perc-sw/phyduino_pico2/docs/reviews/schematic_review_2026-10-06.html

# Phyduino Pico 2: Schematic Design Review

Functional and connectivity review of the four schematic sheets. Part-attribute errors are left for a separate review.

Branch: dev_reva_no_usbpd Rev: A Date: 2026-10-06 Status: critical and high findings #1–#8 resolved (#6–#8 on 2026-10-07); medium #10–#15, #24 and #26 closed; low #16–#22 and #25 closed, #23 deferred; follow-ups noted Basis: kicad-cli 10.0.4 netlist + ERC; datasheets in docs/pdf/datasheets, TPS25947, XC6190, ESP-AT docs

All Critical High Medium Low Toggle dark mode

## Findings by schematic sheet

Number of findings on each sheet, split by severity. Hover a segment for the finding numbers.

Show as table

## Checked and OK

- AP63200 feedback dividers: 3.33 V (196k/62k) and 4.99 V (157k/30k)
- TPS25947 eFuses: limit ≈ 3 A each (RILM 1.1 kΩ); windows ≈ 4.5–22.4 V (barrel/shield) and 4.5–5.6 V (USB); true reverse-current blocking makes the OR'd outputs valid
- TPS2121 pin mapping, highest-voltage mode, OV dividers (≈ 5.53 V), ILIM ≈ 2.6 A
- RP2350 core regulator: 3.3 µH inductor, 4.7 µF on VREG_VIN and DVDD, RC filter on VREG_AVDD
- Decoupling on IOVDD, DVDD and ADC_AVDD (ferrite + 100 nF)
- USB: 27 Ω series resistors, 5.1 kΩ CC resistors, ESD array, shield RC
- SWD connector pinout matches the Raspberry Pi 3-pin debug connector
- Arduino mapping: SPI1 on D10–D13, UART0 on D0/D1, I²C1 on D14/D15
- HSTX lanes on GPIO12–19 with ground between pairs on J7
- ADS7038 on SPI0; I²C0 pull-ups 5.1 kΩ; EEPROM 0x50 and expander 0x43 (no address conflict)
- Boot-select slide switch acting on flash CS through R49
- Shared QSPI bus between flash and PSRAM (apart from finding #4)

Sources: ESP-AT ESP32-C6 hardware connection (https://docs.espressif.com/projects/esp-at/en/latest/esp32c6/Get_Started/Hardware_connection.html) · Torex XC6190 datasheet (https://content.codico.com/fileadmin/media/download/datasheets/torex/xc6190-datasheet.pdf) · TI TPS25947 datasheet (https://www.ti.com/lit/ds/symlink/tps25947.pdf) · RP2350, TPS2121, ESP32-C6-MINI-1 and AP63200 datasheets in the repository.
