perc-sw/phyduino_pico2/docs/images/phyduino_pico2.png

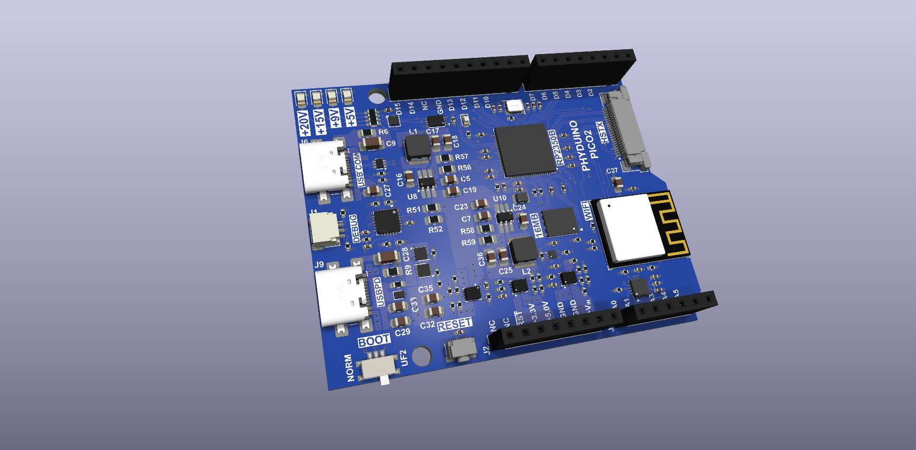
docs/images/phyduino_pico2.png
