perc-sw/phyduino_pico2/docs/pdf/board/phyduino_pico2-schematic.pdf

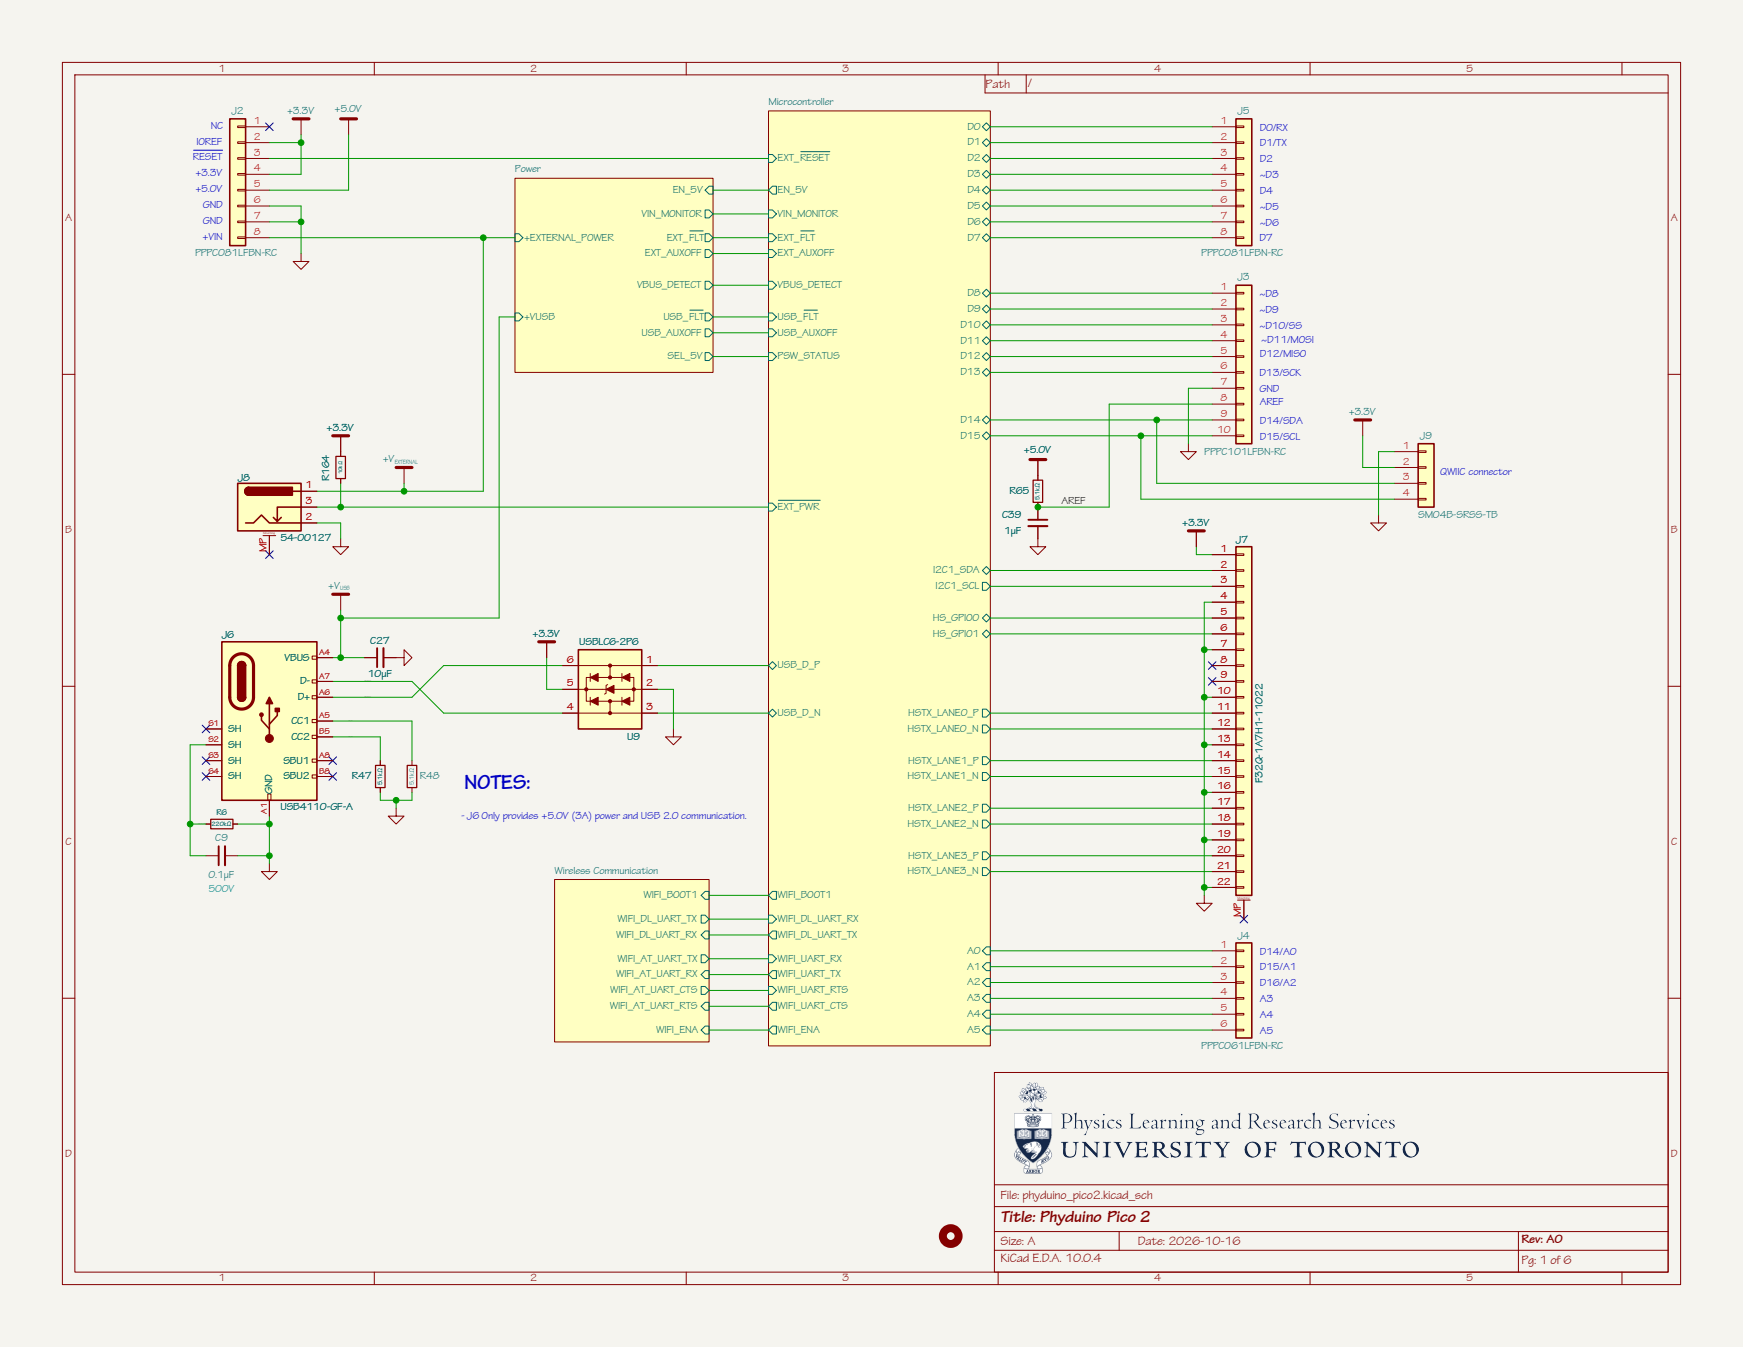
[picture p5: page 1]

10 10 11 11 | Mounting 123456789

12 12
13 13 14 14

15 15
16 16 17 17

- J6 Only provides +5.0V (3A) power and USB 2.0 communication.

File: phyduino_pico2.kicad_sch
Pg: 1 of 6 Title: Phyduino Pico 2

Size: A | Rev: A0
KiCad E.D.A. 10.0.4

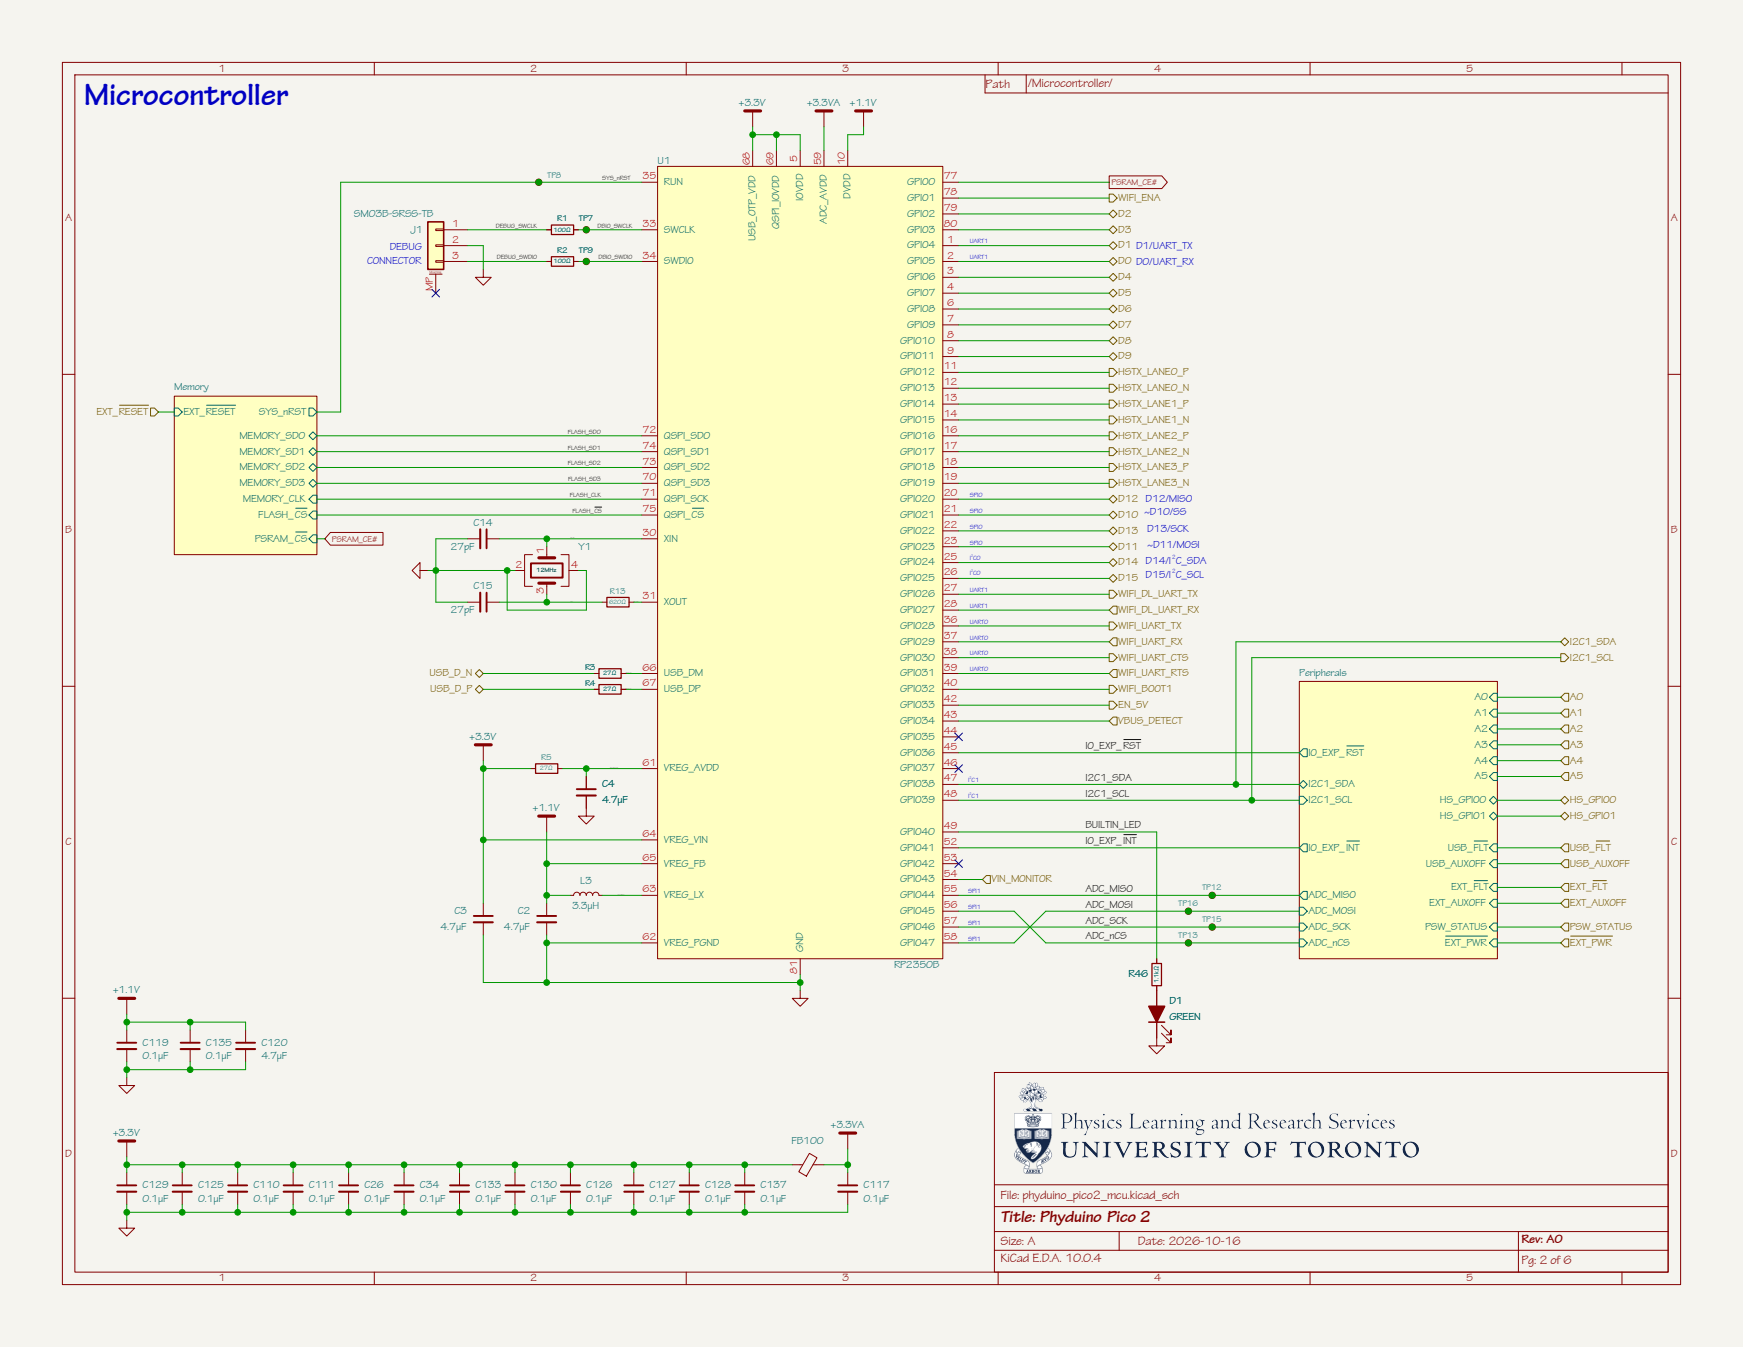
[picture p6: page 2]

I2C1_SDA I2C1
I2C1 I2C1_SCL

IO_EXP_ INT ADC_nCS VIN_MONITOR

SPI1 | TP16 TP15

File: phyduino_pico2_mcu.kicad_sch
Pg: 2 of 6 Title: Phyduino Pico 2

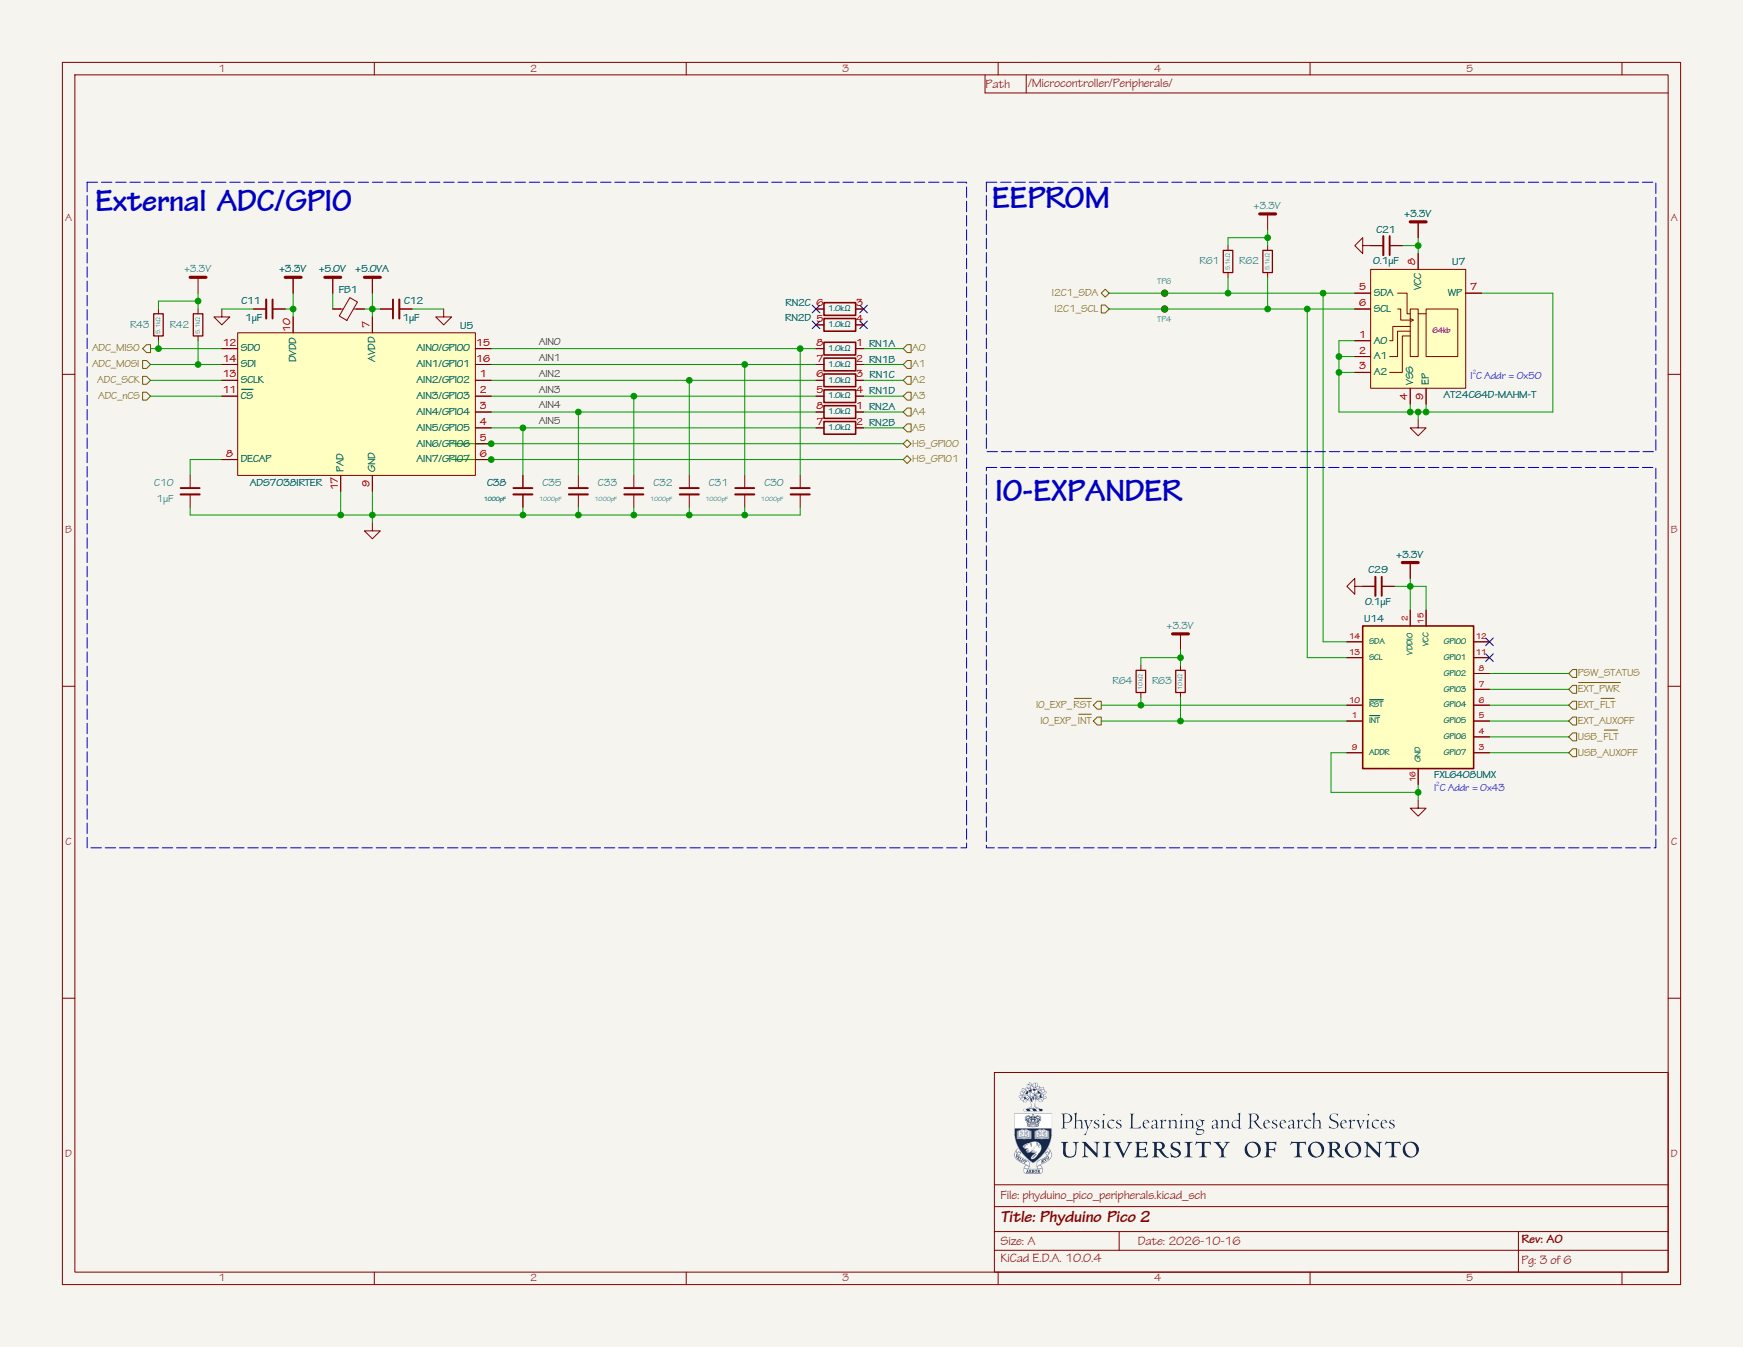
[picture p7: page 3]

File: phyduino_pico_peripherals.kicad_sch
Pg: 3 of 6 Title: Phyduino Pico 2

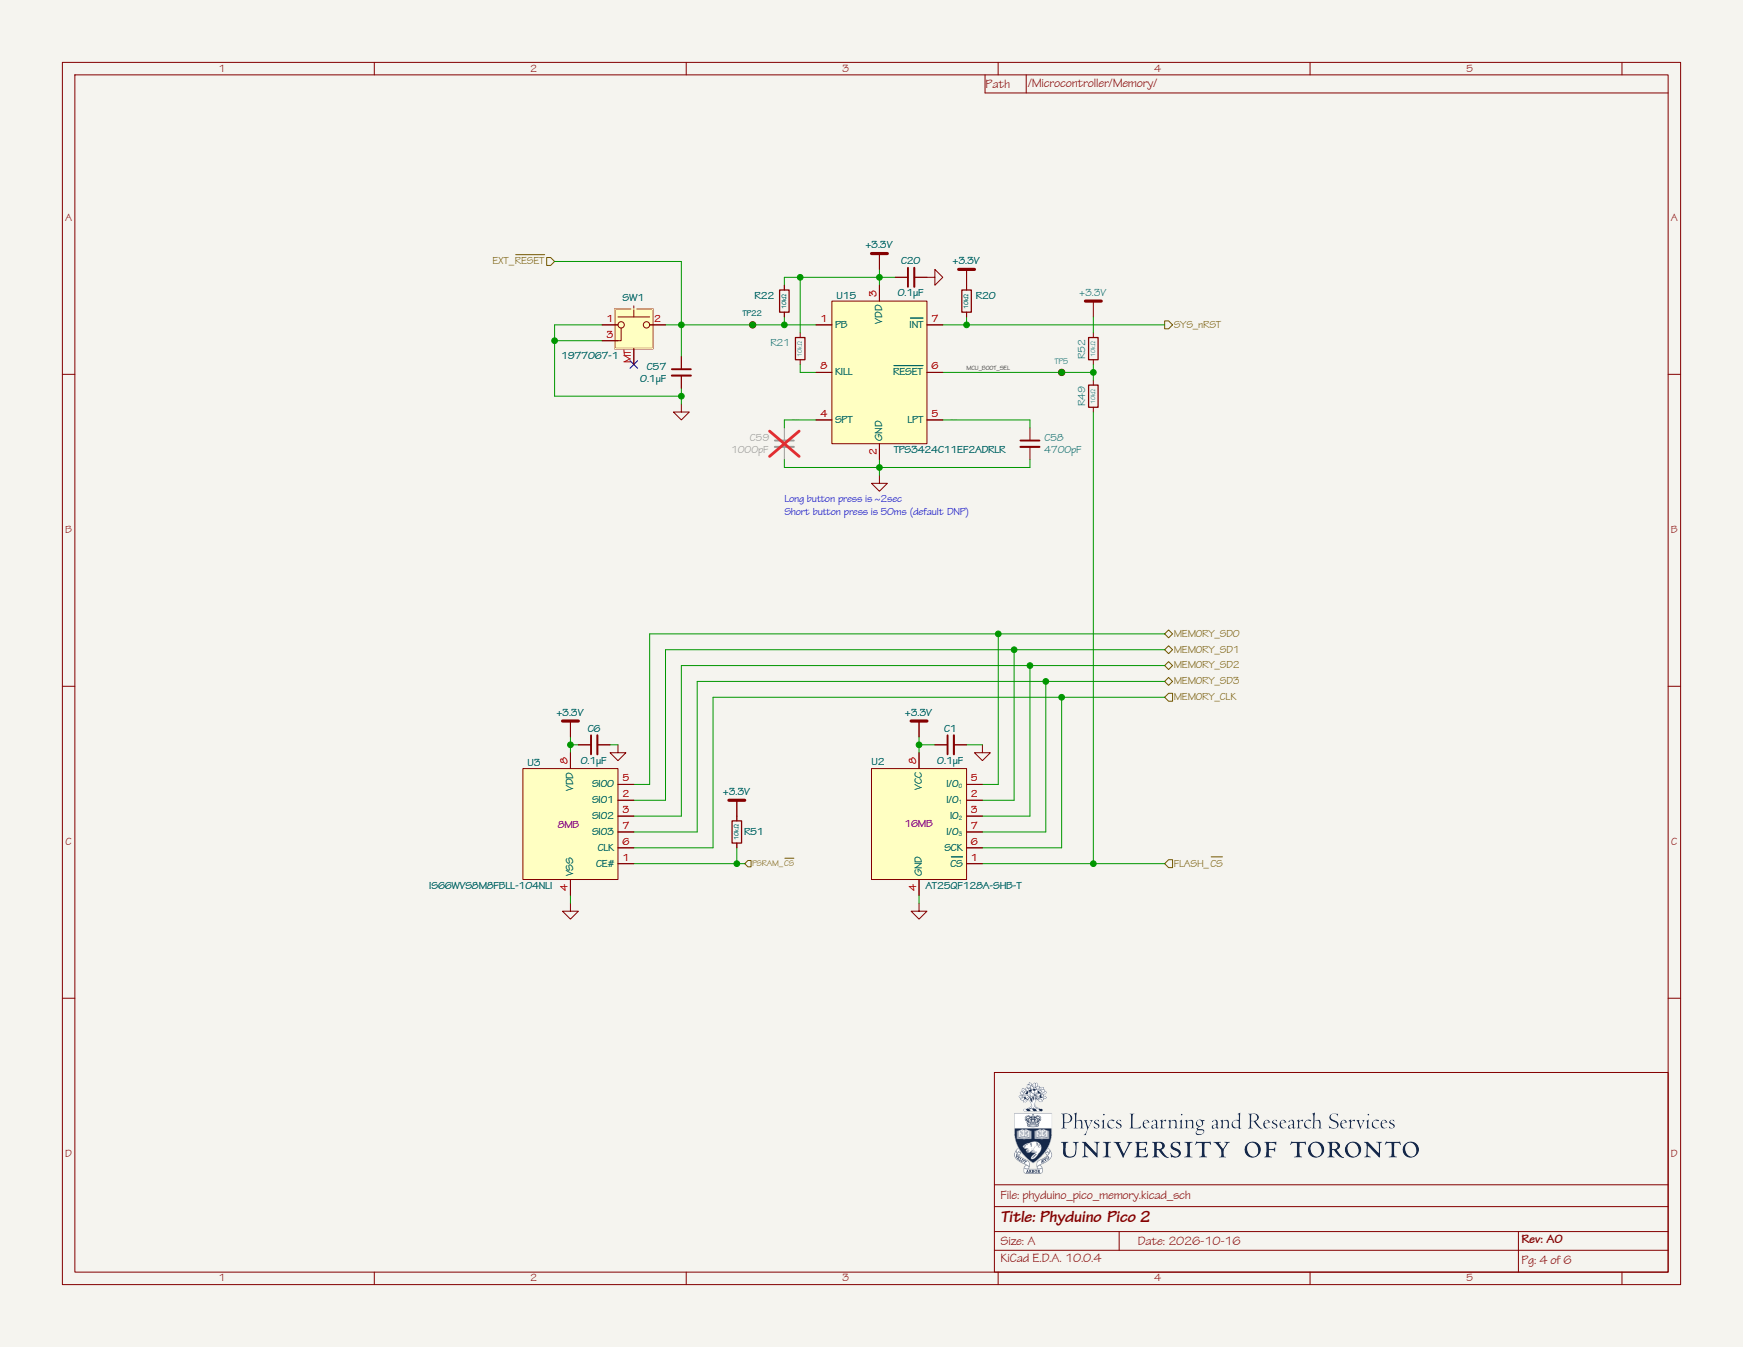
[picture p8: page 4]

File: phyduino_pico_memory.kicad_sch
Pg: 4 of 6 Title: Phyduino Pico 2

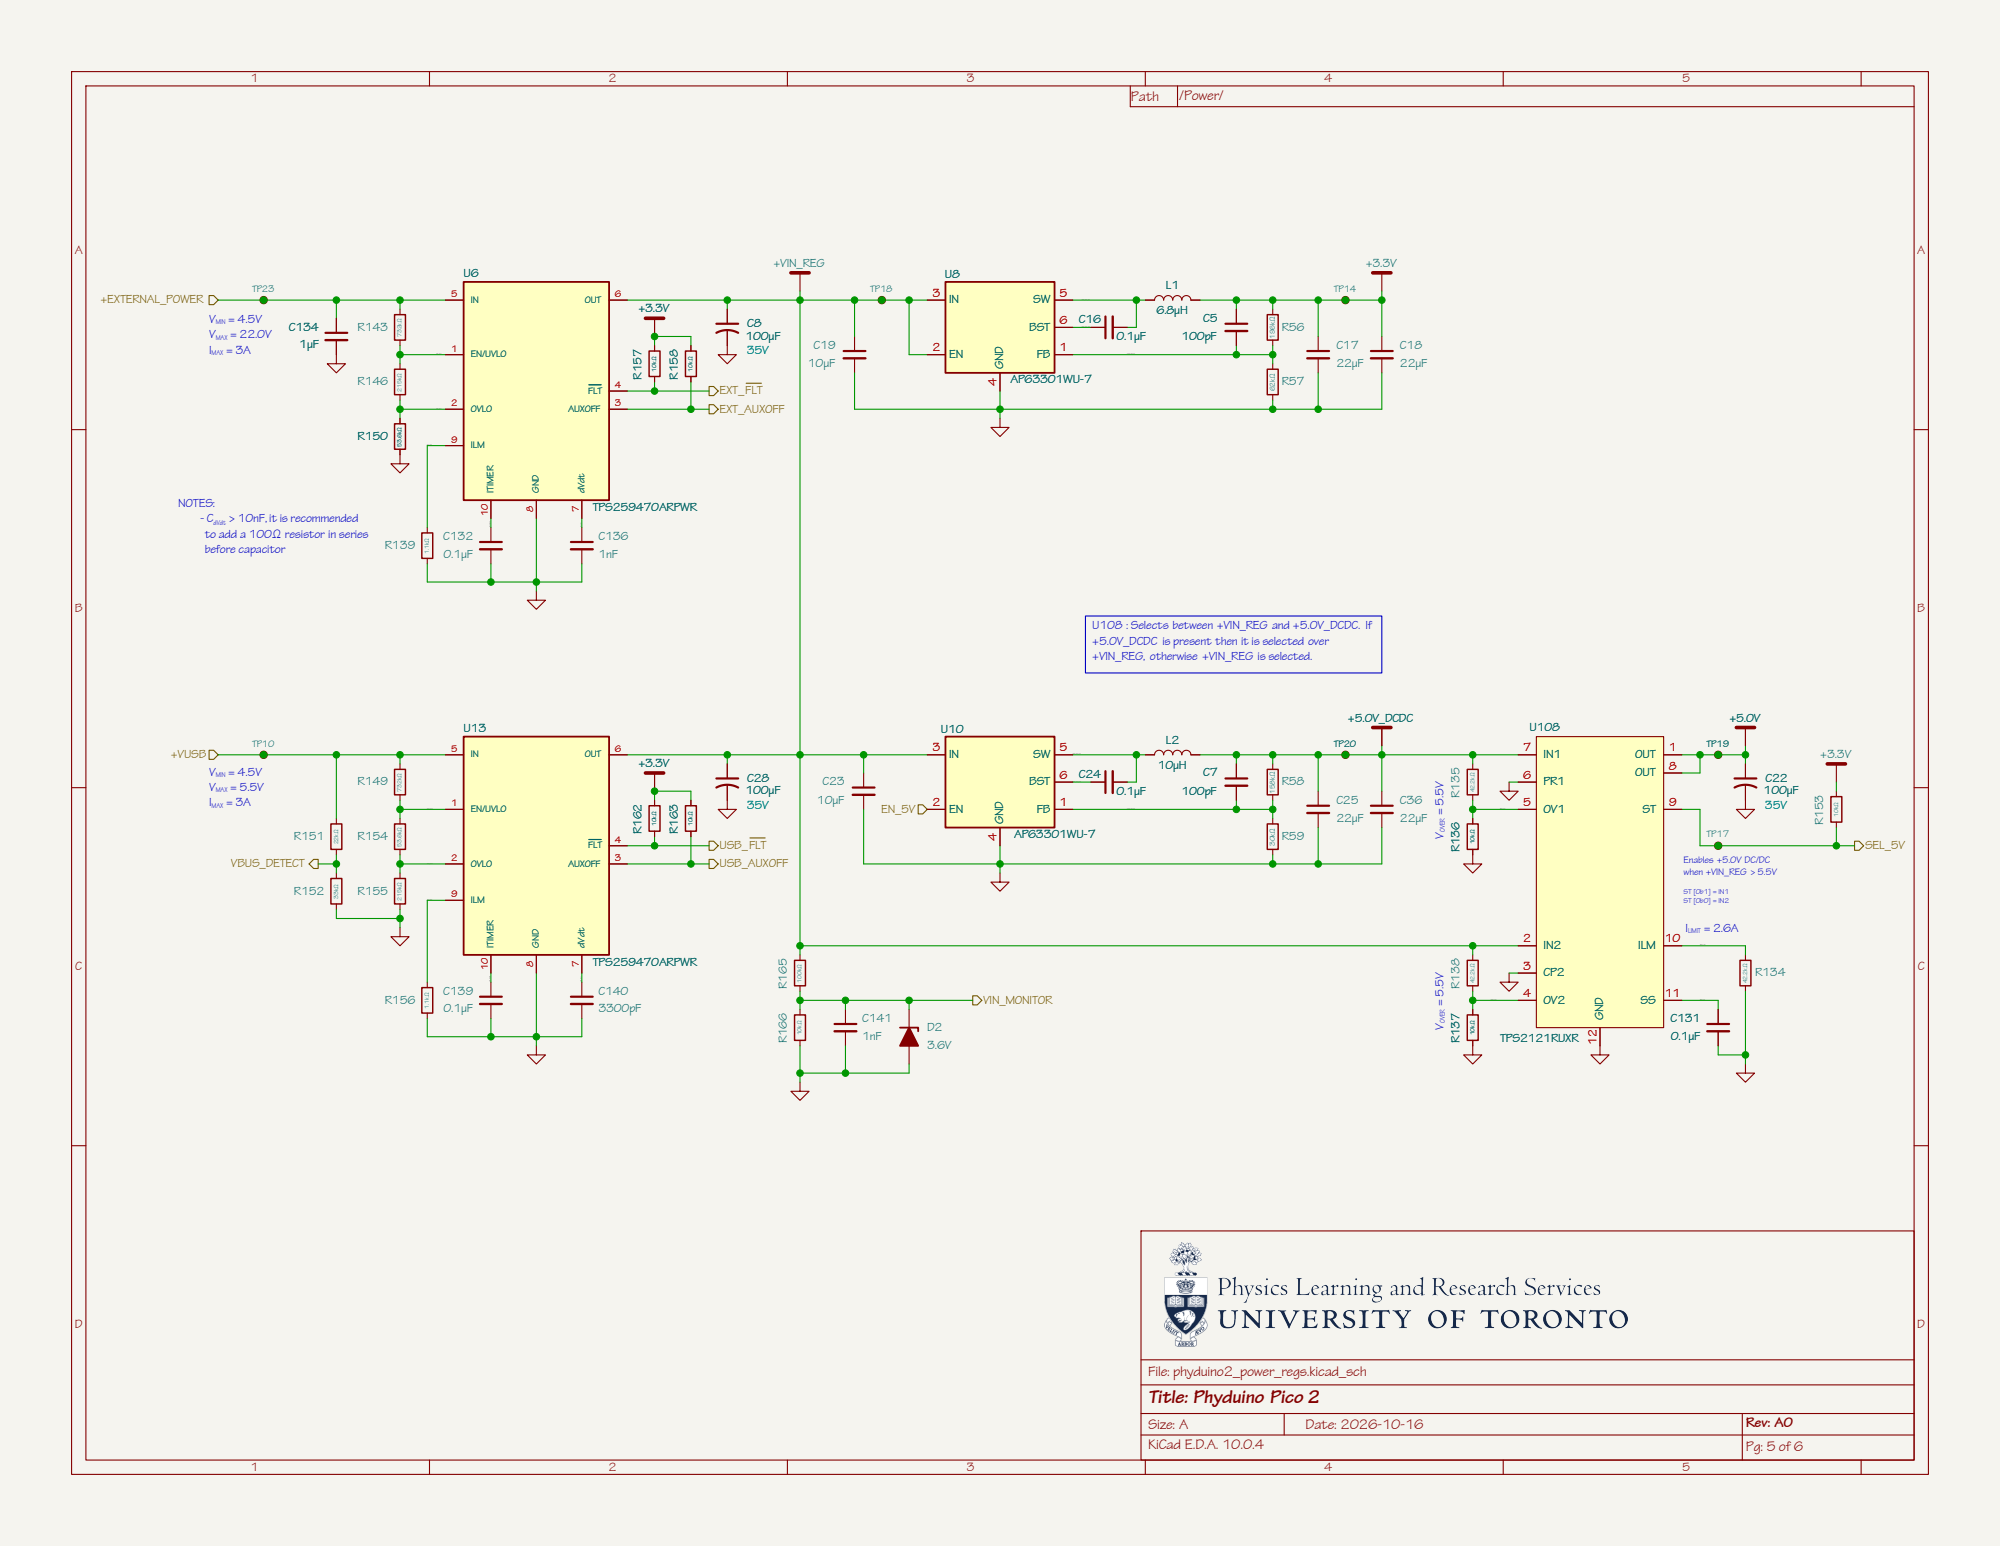
[picture p9: page 5]

Enables +5.0V DC/DC when +VIN_REG > 5.5V

File: phyduino2_power_regs.kicad_sch
Pg: 5 of 6 Title: Phyduino Pico 2

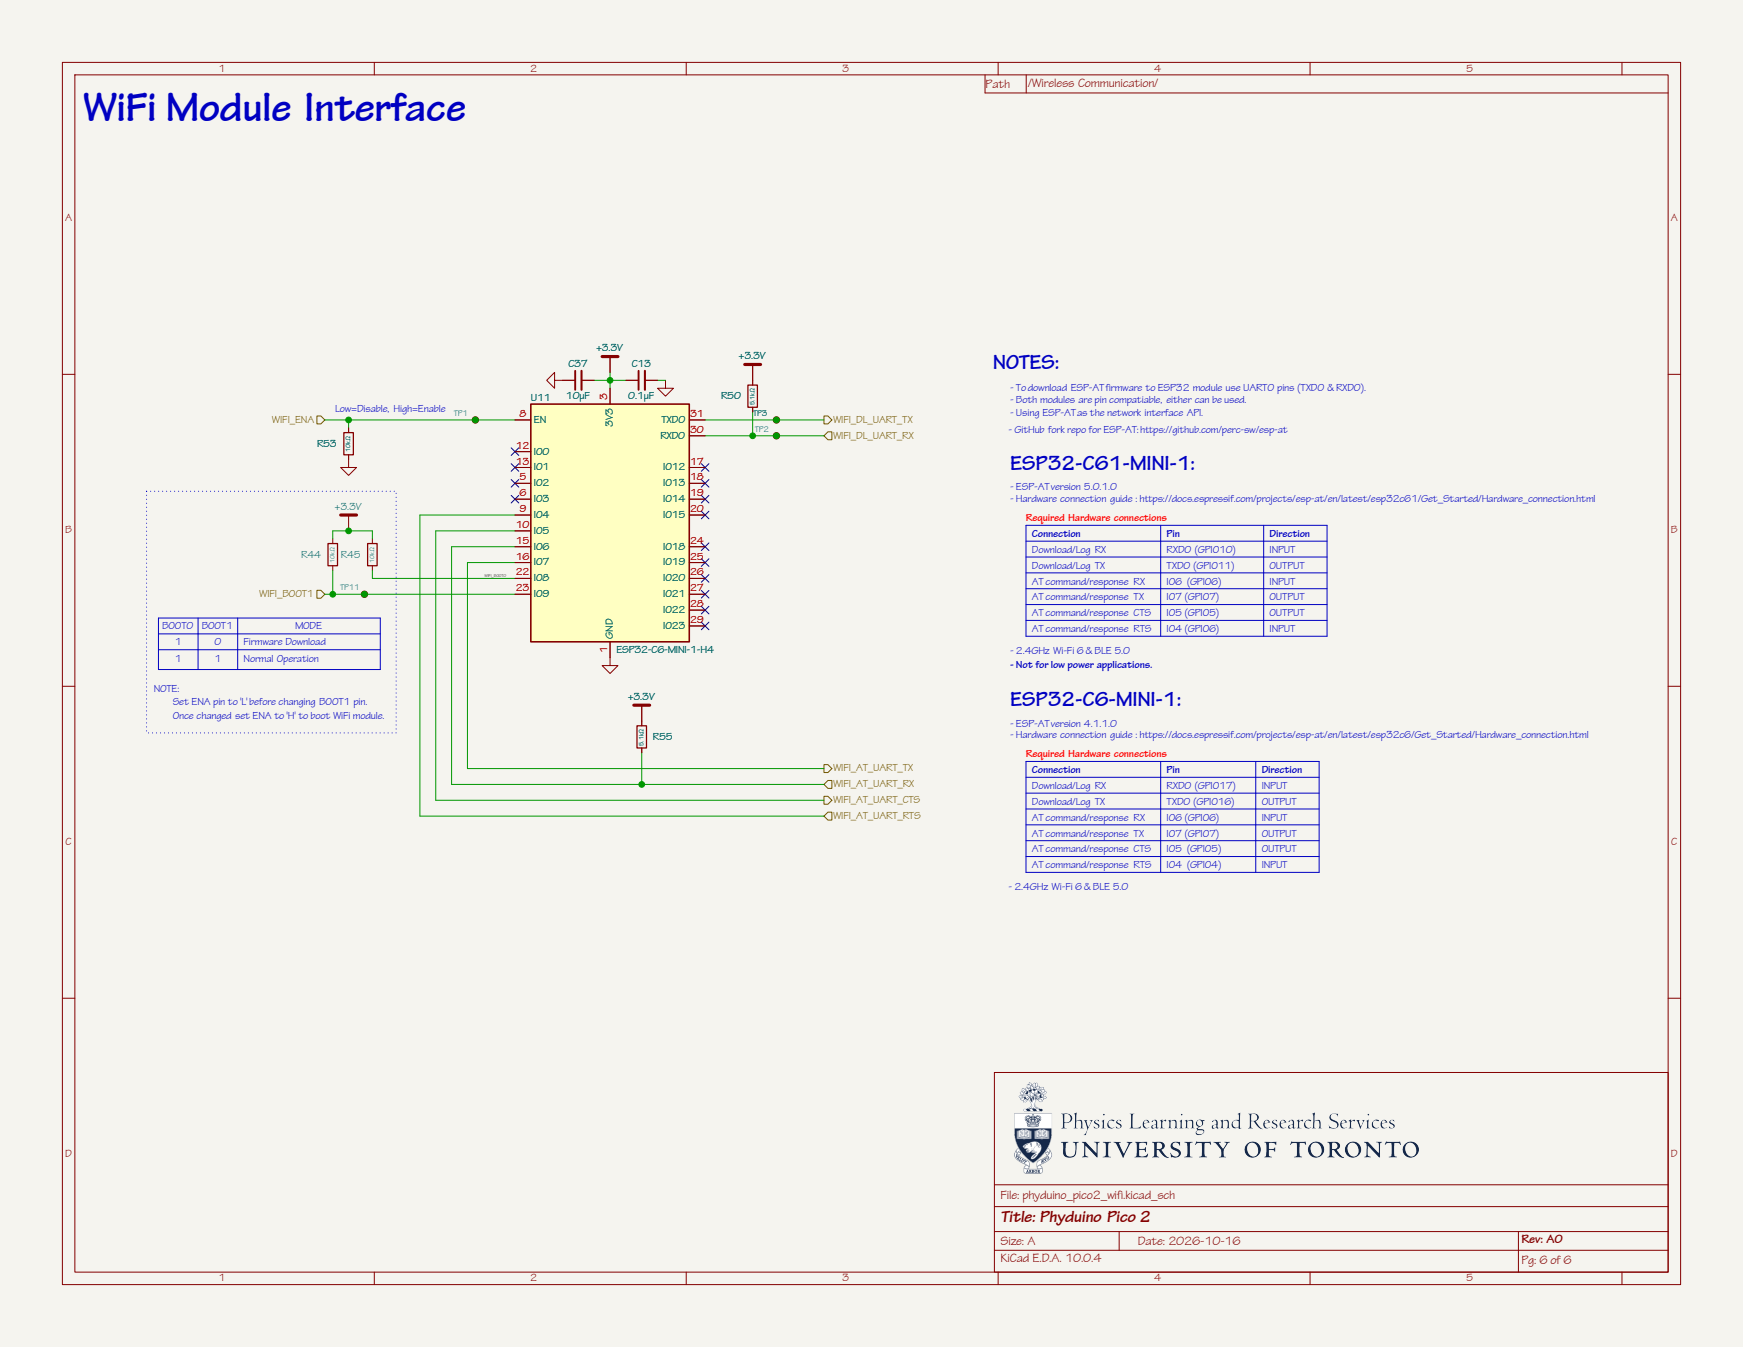
[picture p10: page 6]

Low=Disable, High=Enable WiFi Module Interface

- ESP-AT version 5.0.1.0 NOTES:

- To download ESP-AT firmware to ESP32 module use UART0 pins (TXD0 & RXD0). - Using ESP-AT as the network interface API. - GitHub fork repo for ESP-AT: https://github.com/perc-sw/esp-at
- Both modules are pin compatiable, either can be used. - 2.4GHz Wi-Fi 6 & BLE 5.0 - Not for low power applications.

- ESP-AT version 4.1.1.0 ESP32-C61-MINI-1:

- Hardware connection guide : https://docs.espressif.com/projects/esp-at/en/latest/esp32c61/Get_Started/Hardware_connection.html NOTE: Set ENA pin to 'L' before changing BOOT1 pin. Once changed set ENA to 'H' to boot WiFi module.

- Hardware connection guide : https://docs.espressif.com/projects/esp-at/en/latest/esp32c6/Get_Started/Hardware_connection.html
Required Hardware connections (https://docs.espressif.com/projects/esp-at/en/latest/esp32c5/Get_Started/Hardware_connection.html)

File: phyduino_pico2_wifi.kicad_sch
Pg: 6 of 6 Title: Phyduino Pico 2
