perc-sw/phyduino_pico2/docs/pdf/board/phyduino_pico2_pcb-inner2.pdf

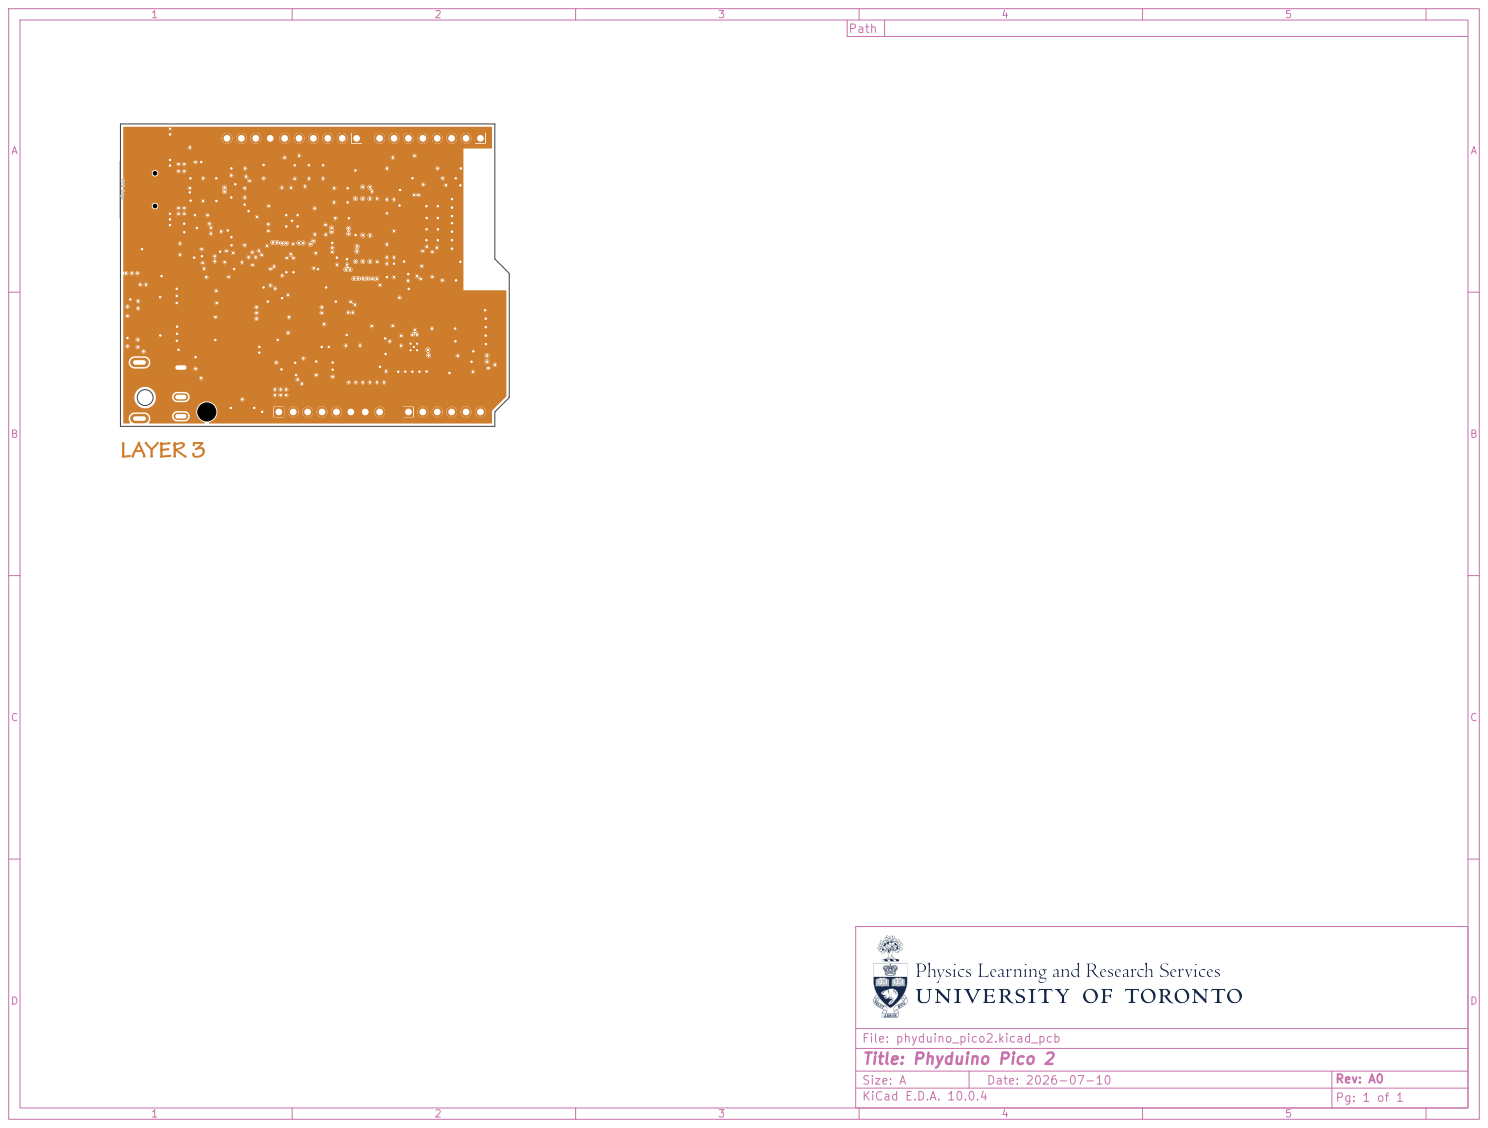
[picture p13: page 1]

Size: A | Rev: A0
KiCad E.D.A. 10.0.4 | Pg: 1 of 1
