perc-sw/phyduino_pico2/pdf/phyduino_pico2_pcb-bottom.pdf

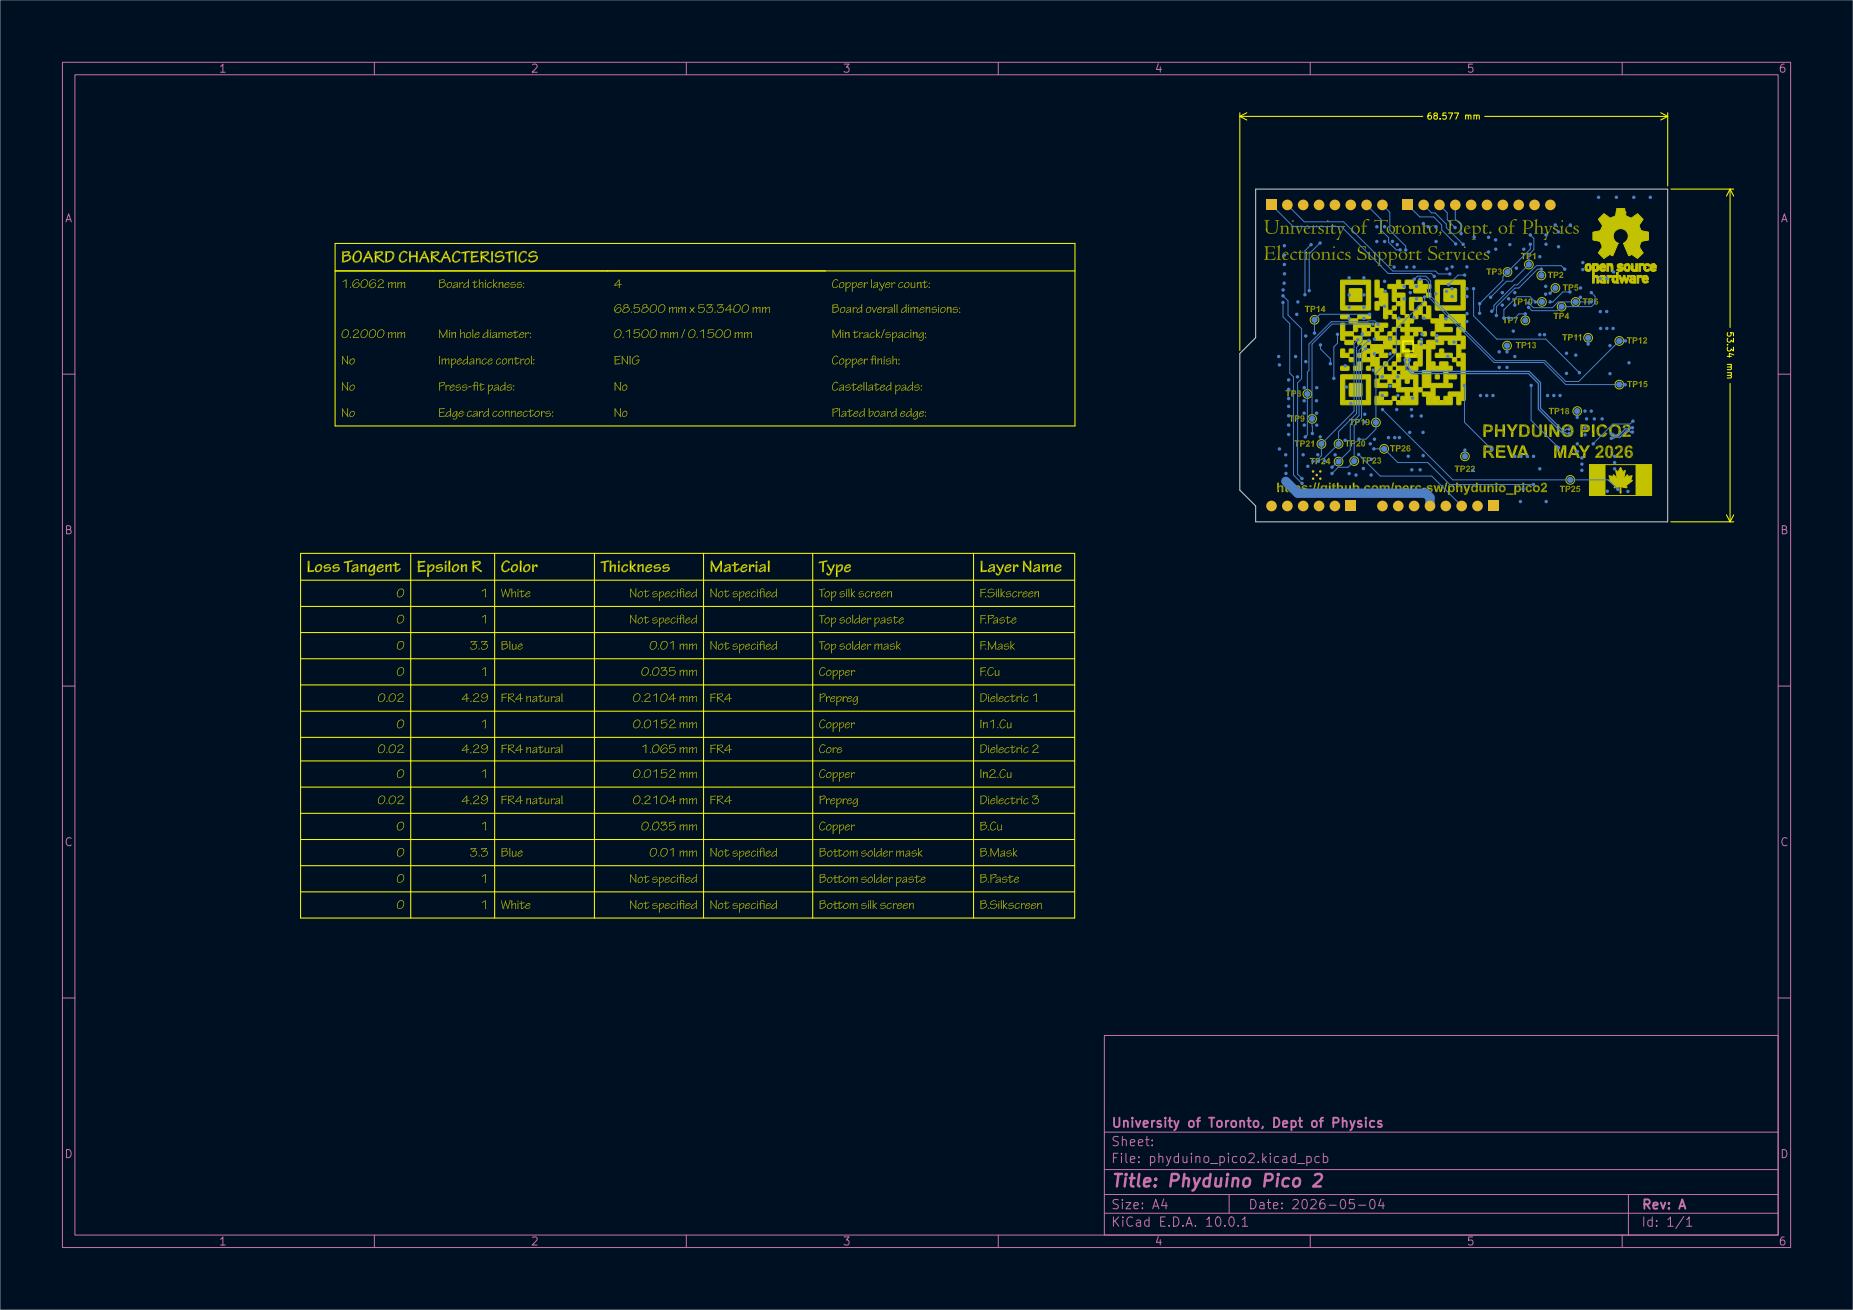
[picture p18: page 1]
