perc-sw/phyduino_pico2/pdf/phyduino_pico2_pcb-top.pdf

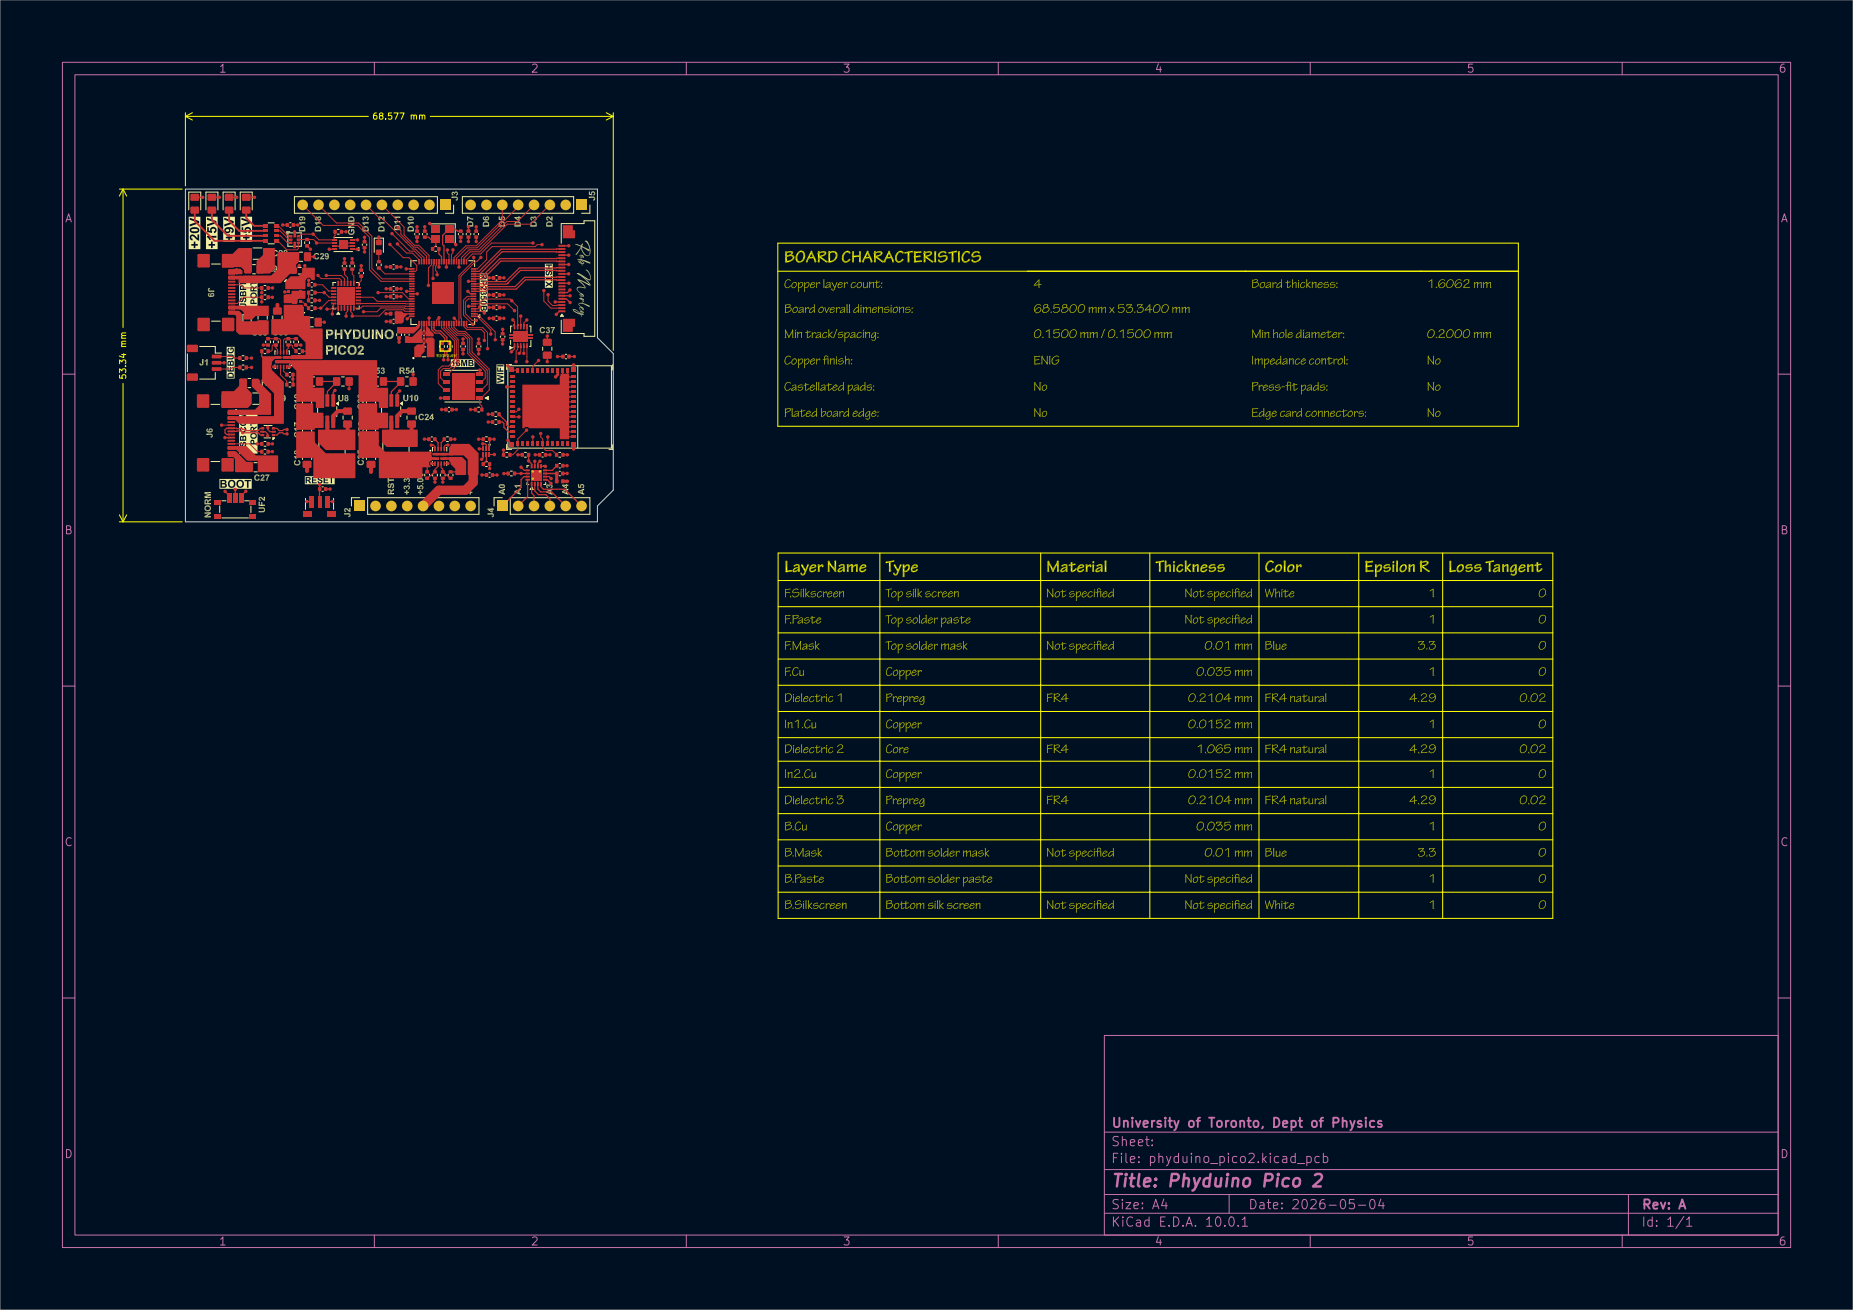
[picture p19: page 1]
