perc-sw/phyduino_pico2/phyduino_pico2.kicad_pcb

## KiCad design phyduino_pico2.kicad_pcb (2026-10-16)

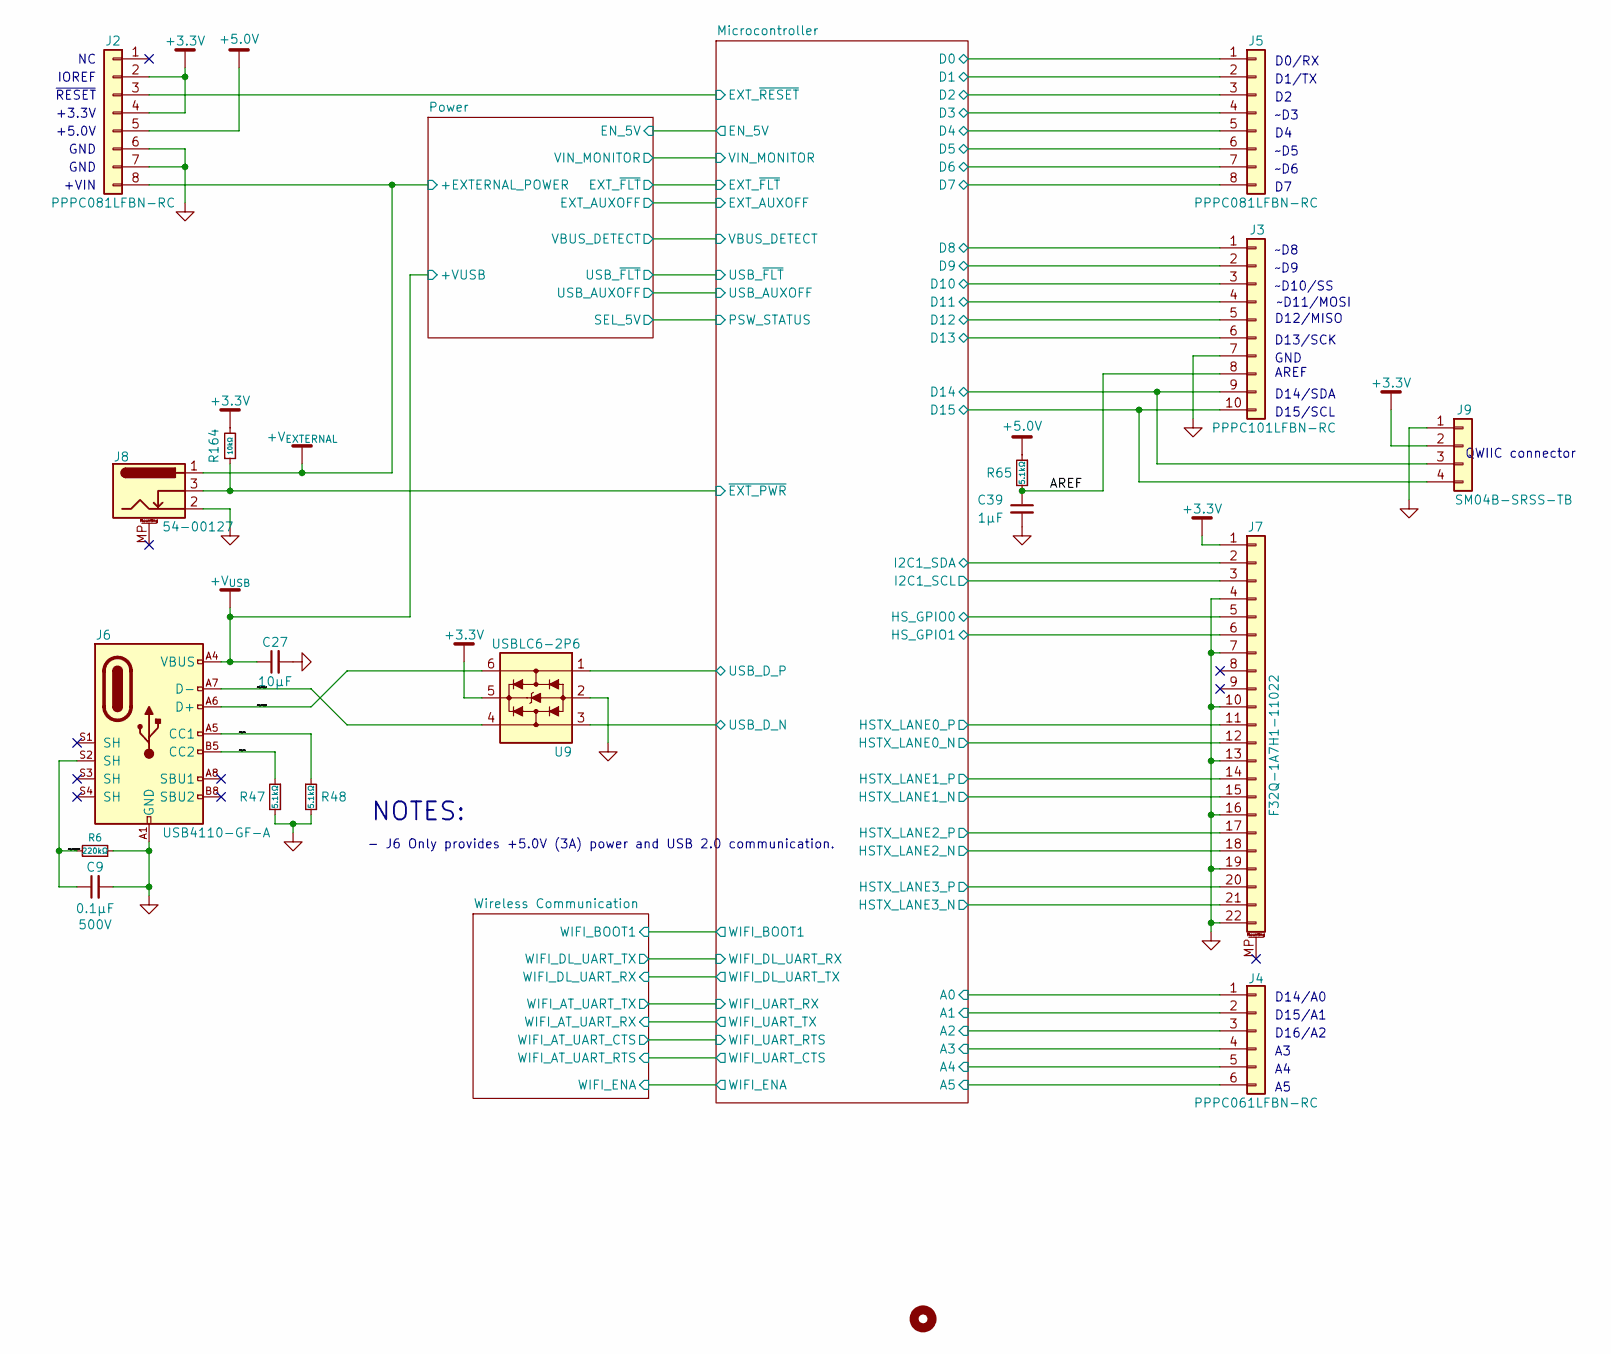
[picture p20: schematic phyduino_pico2.kicad_sch, Phyduino Pico 2]

Parts:
C9: 0.1µF; C_1210_3225Metric; Tolerance ±10%; VOLTAGE 500V; MOUSER_PN 80-C1210C104KCRACTU; LCSC_PN C141218
C27: 10µF; C_0805_2012Metric_Pad1.18x1.45mm_HandSolder; Tolerance ±10%; MOUSER_PN 603-CC0805KKX59BB106; LCSC_PN C440198
C39: 1µF; C_0402_1005Metric; MOUSER_PN 187-CL05A105KO5NNNC; LCSC_PN C29266
H2: MountingHole; MountingHole_3.2mm_M3
J2, J5: PPPC081LFBN-RC; PinSocket_1x08_P2.54mm_Vertical; DIGIKEY_PN S7041-ND
J3: PPPC101LFBN-RC; PinSocket_1x10_P2.54mm_Vertical; DIGIKEY_PN S7043-ND
J4: PPPC061LFBN-RC; PinSocket_1x06_P2.54mm_Vertical; DIGIKEY_PN S7039-ND
J6: USB4110-GF-A; GCT-USBC-GCT_USB4110; MOUSER_PN 640-USB4110-GF-A; LCSC_PN C5143397
J7: F32Q-1A7H1-11022; Amphenol_F32Q-1A7x1-11022_1x22-1MP_P0.5mm_Horizontal; MOUSER_PN 649-F32Q-1A7H1-11022; LCSC PN C19273953
J8: 54-00127; TENSILITY_54-00127; DIGIKEY_PN 839-54-00127-ND
J9: SM04B-SRSS-TB; JST_SH_SM04B-SRSS-TB_1x04-1MP_P1.00mm_Horizontal; MOUSER_PN 306-SM04BSRSSTBLFSN; DIGIKEY_PN 455-SM04B-SRSS-TBCT-ND
R6: 220kΩ; R_0805_2012Metric_Pad1.20x1.40mm_HandSolder; MOUSER_PN 603-RC0805FR-07220KL; LCSC_PN C137568
R47, R48, R65: 5.1kΩ; R_0402_1005Metric; MOUSER_PN 603-RC0402FR-075K1L; LCSC_PN C105872
R164: 10kΩ; R_0402_1005Metric; MOUSER_PN 603-RC0402FR-0710KL; LCSC_PN C60490
U9: USBLC6-2P6; SOT-666; MOUSER_PN 511-USBLC6-2P6; LCSC_PN C2827693

Connections:
+3.3V: J2.2, J2.4, J7.1, J9.2, R164.2, U9.5 (VBUS); also elsewhere on the board
+5.0V: J2.5, R65.1; also elsewhere on the board
+V_{EXTERNAL}: J2.8, J8.1; also elsewhere on the board
+V_{USB}: C27.1, J6.A4 (VBUS), J6.A9 (VBUS), J6.B4 (VBUS), J6.B9 (VBUS); also elsewhere on the board
/AREF: C39.1, J3.8, R65.2
/Microcontroller/A0: J4.1; also elsewhere on the board
/Microcontroller/A1: J4.2; also elsewhere on the board
/Microcontroller/A2: J4.3; also elsewhere on the board
/Microcontroller/A3: J4.4; also elsewhere on the board
/Microcontroller/A4: J4.5; also elsewhere on the board
/Microcontroller/A5: J4.6; also elsewhere on the board
/Microcontroller/D0: J5.1; also elsewhere on the board
/Microcontroller/D1: J5.2; also elsewhere on the board
/Microcontroller/D2: J5.3; also elsewhere on the board
/Microcontroller/D3: J5.4; also elsewhere on the board
/Microcontroller/D4: J5.5; also elsewhere on the board
/Microcontroller/D5: J5.6; also elsewhere on the board
/Microcontroller/D6: J5.7; also elsewhere on the board
/Microcontroller/D7: J5.8; also elsewhere on the board
/Microcontroller/D8: J3.1; also elsewhere on the board
/Microcontroller/D9: J3.2; also elsewhere on the board
/Microcontroller/D10: J3.3; also elsewhere on the board
/Microcontroller/D11: J3.4; also elsewhere on the board
/Microcontroller/D12: J3.5; also elsewhere on the board
/Microcontroller/D13: J3.6; also elsewhere on the board
/Microcontroller/D14: J3.9, J9.3; also elsewhere on the board
/Microcontroller/D15: J3.10, J9.4; also elsewhere on the board
/Microcontroller/EXT_~RESET: J2.3; also elsewhere on the board
/Microcontroller/HSTX_LANE0_N: J7.12; also elsewhere on the board
/Microcontroller/HSTX_LANE0_P: J7.11; also elsewhere on the board
/Microcontroller/HSTX_LANE1_N: J7.15; also elsewhere on the board
/Microcontroller/HSTX_LANE1_P: J7.14; also elsewhere on the board
/Microcontroller/HSTX_LANE2_N: J7.18; also elsewhere on the board
/Microcontroller/HSTX_LANE2_P: J7.17; also elsewhere on the board
/Microcontroller/HSTX_LANE3_N: J7.21; also elsewhere on the board
/Microcontroller/HSTX_LANE3_P: J7.20; also elsewhere on the board
/Microcontroller/HS_GPIO0: J7.5; also elsewhere on the board
/Microcontroller/HS_GPIO1: J7.6; also elsewhere on the board
/Microcontroller/I2C1_SCL: J7.3; also elsewhere on the board
/Microcontroller/I2C1_SDA: J7.2; also elsewhere on the board
/Microcontroller/USB_D_N: U9.3 (I/O2); also elsewhere on the board
/Microcontroller/USB_D_P: U9.1 (I/O1); also elsewhere on the board
/Microcontroller/~EXT_PWR: J8.3, R164.1; also elsewhere on the board
/USB_CC1: J6.A5 (CC1), R48.1
/USB_CC2: J6.B5 (CC2), R47.1
/USB_COM_D_N: J6.A7 (D-), J6.B7 (D-), U9.4 (I/O2)
/USB_COM_D_P: J6.A6 (D+), J6.B6 (D+), U9.6 (I/O1)
/USB_COM_SHIELD: C9.1, J6.S2 (SH), R6.1
GND: C9.2, C27.2, C39.2, J2.6, J2.7, J3.7, J6.A1 (GND), J6.A12 (GND), J6.B1 (GND), J6.B12 (GND), J7.4, J7.7, J7.10, J7.13, J7.16, J7.19, J7.22, J8.2, J9.1, R6.2, R47.2, R48.2, U9.2 (GND); also elsewhere on the board

Notes on the sheet:
GND
D15/SCL
D14/SDA
D12/MISO
~{RESET}
AREF
+VIN
D14/A0
D0/RX
NOTES:
D1/TX
~D5
D15/A1
- J6 Only provides +5.0V (3A) power and USB 2.0 communication.
~D8
~D6
D13/SCK
~D11/MOSI
D16/A2
IOREF
+3.3V
~D9
+5.0V
~D10/SS
~D3
QWIIC connector

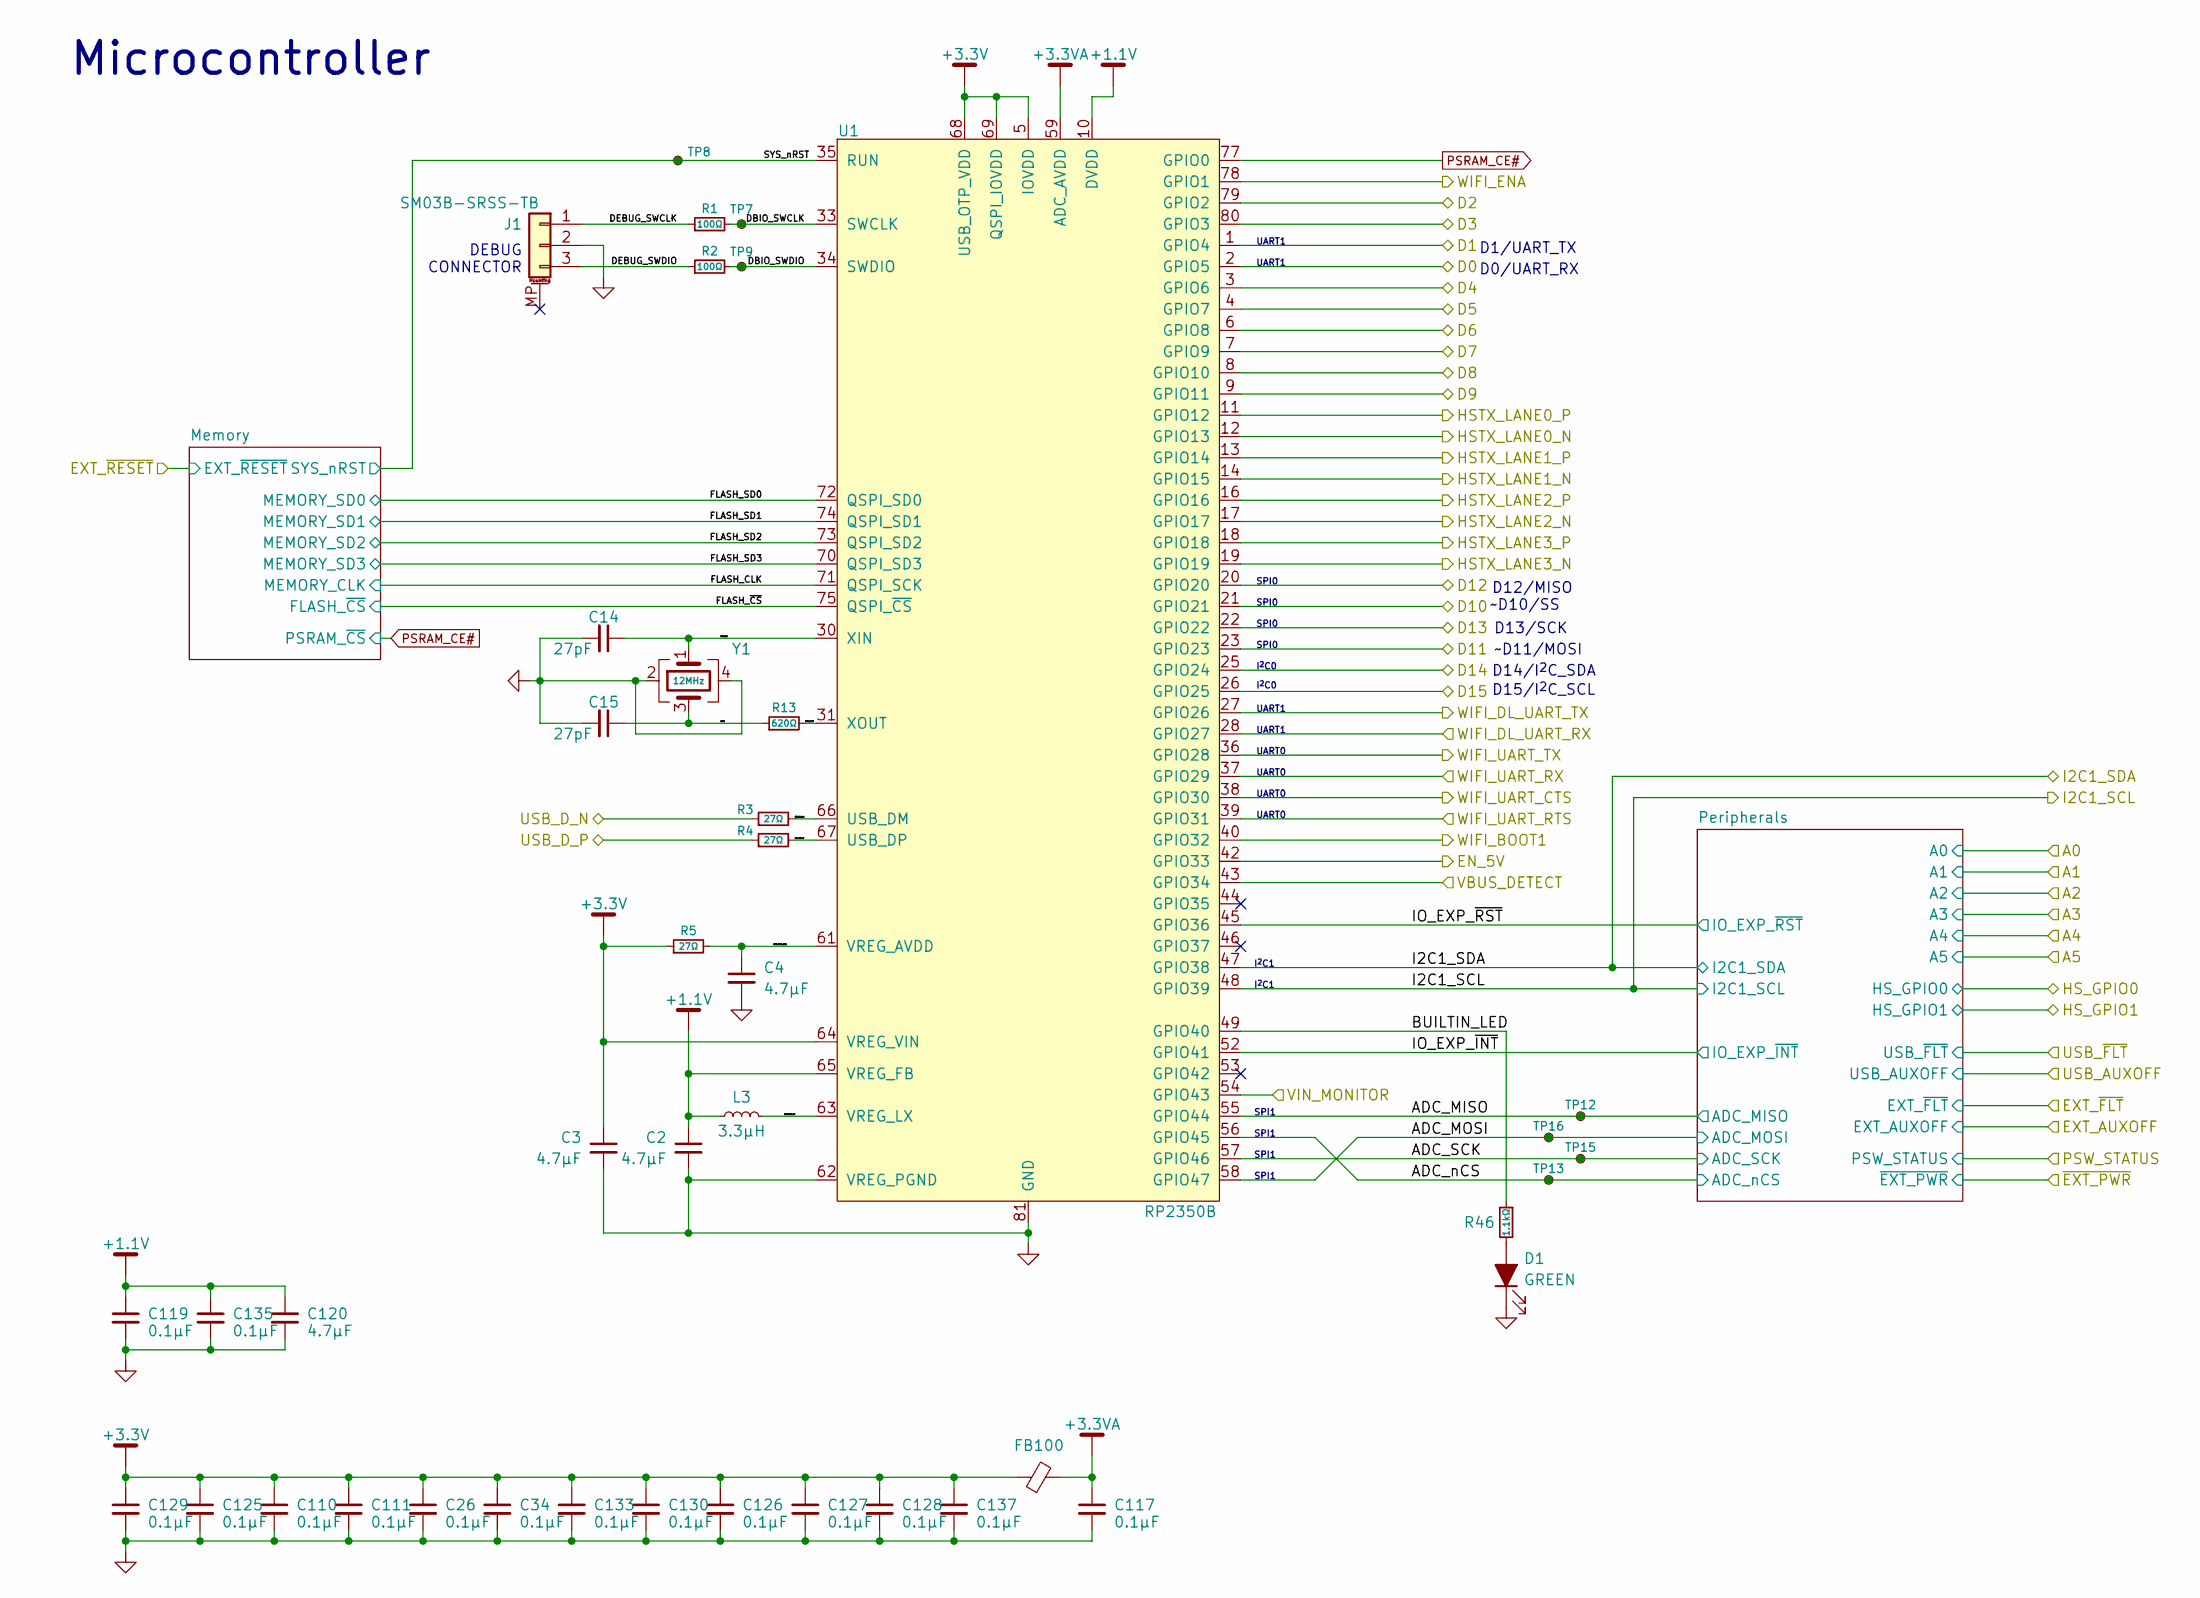
[picture p21: schematic phyduino_pico2_mcu.kicad_sch, Phyduino Pico 2]

Parts:
C2, C3, C4, C120: 4.7µF; C_0402_1005Metric; MOUSER_PN 810-C1005X5R1A475KBC; LCSC_PN C368809
C14, C15: 27pF; C_0402_1005Metric; Tolerance ±5%; MOUSER_PN 81-GRM1555C1H270JA1D; LCSC_PN C1557
C26, C34, C110, C111, C117, C119, C125, C126, C127, C128, C129, C130, C133, C135, C137: 0.1µF; C_0402_1005Metric; Tolerance ±10%; MOUSER_PN 81-GCM155R71H104KE2J; LCSC_PN C85858
D1: GREEN; LED_0603_1608Metric; MOUSER_PN 859-LTST-C190GKT; LCSC_PN C125094
FB100: MPZ1005S221HT000; L_0402_1005Metric; MOUSER_PN 810-MPZ1005S221HT000; LCSC PN C2844537
J1: SM03B-SRSS-TB; JST_SH_SM03B-SRSS-TB_1x03-1MP_P1.00mm_Horizontal; LCSC_PN C7430445
L3: 3.3µH; L_Abracon_AOTA-B201610S; MOUSER_PN 815-AB201610S3R3101T; LCSC PN C42411119
R1, R2: 100Ω; R_0402_1005Metric; MOUSER_PN 603-RC0402FR-07100RL; LCSC_PN C106232
R3, R4, R5: 27Ω; R_0402_1005Metric; MOUSER_PN 603-RC0402FR-0727RL; LCSC_PN C2909343
R13: 620Ω; R_0402_1005Metric; MOUSER_PN 603-RC0402FR-07620RL; LCSC_PN C413077
R46: 1.1kΩ; R_0402_1005Metric; MOUSER_PN 603-RC0402FR-071K1L; LCSC_PN C2909306
TP7, TP8, TP9, TP12, TP13, TP15, TP16: TestPoint_Small; TestPoint_SameSky_CPG-47-TH-B
U1: RP2350B; QFN-80-1EP_10x10mm_P0.4mm_EP3.4x3.4mm; MOUSER_PN 358-SC1510; LCSC PN C42415655
Y1: ABM8G-12.000MHZ-18-D2Y-T; Crystal_SMD_Abracon_ABM8AIG-4Pin_3.2x2.5mm; MOUSER_PN 815-ABM8G-12-18D2Y; DIGIKEY_PN 535-10261-1-ND

Connections:
+1.1V: C2.1, C119.1, C120.1, C135.1, L3.1, U1.10 (DVDD), U1.32 (DVDD), U1.51 (DVDD), U1.65 (VREG_FB)
+3.3V: C3.1, C26.1, C34.1, C110.1, C111.1, C125.1, C126.1, C127.1, C128.1, C129.1, C130.1, C133.1, C137.1, FB100.1, R5.1, U1.5 (IOVDD), U1.15 (IOVDD), U1.24 (IOVDD), U1.29 (IOVDD), U1.41 (IOVDD), U1.50 (IOVDD), U1.60 (IOVDD), U1.64 (VREG_VIN), U1.68 (USB_OTP_VDD), U1.69 (QSPI_IOVDD), U1.76 (IOVDD); also elsewhere on the board
+3.3VA: C117.1, FB100.2, U1.59 (ADC_AVDD)
/Microcontroller/ADC_MISO: TP12.1 (1_1), U1.55 (GPIO44); also elsewhere on the board
/Microcontroller/ADC_MOSI: TP16.1 (1_1), U1.58 (GPIO47); also elsewhere on the board
/Microcontroller/ADC_SCK: TP15.1 (1_1), U1.57 (GPIO46); also elsewhere on the board
/Microcontroller/ADC_nCS: TP13.1 (1_1), U1.56 (GPIO45); also elsewhere on the board
/Microcontroller/BUILTIN_LED: R46.1, U1.49 (GPIO40)
/Microcontroller/D0: U1.2 (GPIO5); also elsewhere on the board
/Microcontroller/D1: U1.1 (GPIO4); also elsewhere on the board
/Microcontroller/D2: U1.79 (GPIO2); also elsewhere on the board
/Microcontroller/D3: U1.80 (GPIO3); also elsewhere on the board
/Microcontroller/D4: U1.3 (GPIO6); also elsewhere on the board
/Microcontroller/D5: U1.4 (GPIO7); also elsewhere on the board
/Microcontroller/D6: U1.6 (GPIO8); also elsewhere on the board
/Microcontroller/D7: U1.7 (GPIO9); also elsewhere on the board
/Microcontroller/D8: U1.8 (GPIO10); also elsewhere on the board
/Microcontroller/D9: U1.9 (GPIO11); also elsewhere on the board
/Microcontroller/D10: U1.21 (GPIO21); also elsewhere on the board
/Microcontroller/D11: U1.23 (GPIO23); also elsewhere on the board
/Microcontroller/D12: U1.20 (GPIO20); also elsewhere on the board
/Microcontroller/D13: U1.22 (GPIO22); also elsewhere on the board
/Microcontroller/D14: U1.25 (GPIO24); also elsewhere on the board
/Microcontroller/D15: U1.26 (GPIO25); also elsewhere on the board
/Microcontroller/DBIO_SWCLK: R1.2, TP7.1 (1_1), U1.33 (SWCLK)
/Microcontroller/DBIO_SWDIO: R2.2, TP9.1 (1_1), U1.34 (SWDIO)
/Microcontroller/DEBUG_SWCLK: J1.1, R1.1
/Microcontroller/DEBUG_SWDIO: J1.3, R2.1
/Microcontroller/EN_5V: U1.42 (GPIO33); also elsewhere on the board
/Microcontroller/FLASH_CLK: U1.71 (QSPI_SCK); also elsewhere on the board
/Microcontroller/FLASH_SD0: U1.72 (QSPI_SD0); also elsewhere on the board
/Microcontroller/FLASH_SD1: U1.74 (QSPI_SD1); also elsewhere on the board
/Microcontroller/FLASH_SD2: U1.73 (QSPI_SD2); also elsewhere on the board
/Microcontroller/FLASH_SD3: U1.70 (QSPI_SD3); also elsewhere on the board
/Microcontroller/FLASH_~CS: U1.75 (QSPI_~CS); also elsewhere on the board
/Microcontroller/HSTX_LANE0_N: U1.12 (GPIO13); also elsewhere on the board
/Microcontroller/HSTX_LANE0_P: U1.11 (GPIO12); also elsewhere on the board
/Microcontroller/HSTX_LANE1_N: U1.14 (GPIO15); also elsewhere on the board
/Microcontroller/HSTX_LANE1_P: U1.13 (GPIO14); also elsewhere on the board
/Microcontroller/HSTX_LANE2_N: U1.17 (GPIO17); also elsewhere on the board
/Microcontroller/HSTX_LANE2_P: U1.16 (GPIO16); also elsewhere on the board
/Microcontroller/HSTX_LANE3_N: U1.19 (GPIO19); also elsewhere on the board
/Microcontroller/HSTX_LANE3_P: U1.18 (GPIO18); also elsewhere on the board
/Microcontroller/I2C1_SCL: U1.48 (GPIO39); also elsewhere on the board
/Microcontroller/I2C1_SDA: U1.47 (GPIO38); also elsewhere on the board
/Microcontroller/IO_EXP_~INT: U1.52 (GPIO41); also elsewhere on the board
/Microcontroller/IO_EXP_~RST: U1.45 (GPIO36); also elsewhere on the board
/Microcontroller/MCU_VREG_AVDD: C4.1, R5.2, U1.61 (VREG_AVDD)
/Microcontroller/MCU_VREG_LX: L3.2, U1.63 (VREG_LX)
/Microcontroller/MCU_XIN: C14.1, U1.30 (XIN), Y1.1
/Microcontroller/MCU_XOUT: R13.2, U1.31 (XOUT)
/Microcontroller/SYS_nRST: TP8.1 (1_1), U1.35 (RUN); also elsewhere on the board
/Microcontroller/USB_D_N: R3.1; also elsewhere on the board
/Microcontroller/USB_D_P: R4.1; also elsewhere on the board
/Microcontroller/USB_IO_D_N: R3.2, U1.66 (USB_DM)
/Microcontroller/USB_IO_D_P: R4.2, U1.67 (USB_DP)
/Microcontroller/VBUS_DETECT: U1.43 (GPIO34); also elsewhere on the board
/Microcontroller/VIN_MONITOR: U1.54 (GPIO43); also elsewhere on the board
/Microcontroller/WIFI_BOOT1: U1.40 (GPIO32); also elsewhere on the board
/Microcontroller/WIFI_DL_UART_RX: U1.28 (GPIO27); also elsewhere on the board
/Microcontroller/WIFI_DL_UART_TX: U1.27 (GPIO26); also elsewhere on the board
/Microcontroller/WIFI_ENA: U1.78 (GPIO1); also elsewhere on the board
/Microcontroller/WIFI_UART_CTS: U1.38 (GPIO30); also elsewhere on the board
/Microcontroller/WIFI_UART_RTS: U1.39 (GPIO31); also elsewhere on the board
/Microcontroller/WIFI_UART_RX: U1.37 (GPIO29); also elsewhere on the board
/Microcontroller/WIFI_UART_TX: U1.36 (GPIO28); also elsewhere on the board
/Microcontroller/XOUT: C15.1, R13.1, Y1.3
GND: C2.2, C3.2, C4.2, C14.2, C15.2, C26.2, C34.2, C110.2, C111.2, C117.2, C119.2, C120.2, C125.2, C126.2, C127.2, C128.2, C129.2, C130.2, C133.2, C135.2, C137.2, D1.1 (K), J1.2, U1.62 (VREG_PGND), U1.81 (GND), Y1.2, Y1.4; also elsewhere on the board
unnamed: D1.2 (A), R46.2
PSRAM_CE#: U1.77 (GPIO0); also elsewhere on the board

Notes on the sheet:
Microcontroller
UART0
I^{2}C1
I^{2}C0
SPI0
D0/UART_RX
~D10/SS
UART1
~D11/MOSI
D15/I^{2}C_SCL
SPI1
DEBUG CONNECTOR
UART1
D13/SCK
D1/UART_TX
SPI0
D14/I^{2}C_SDA
D12/MISO

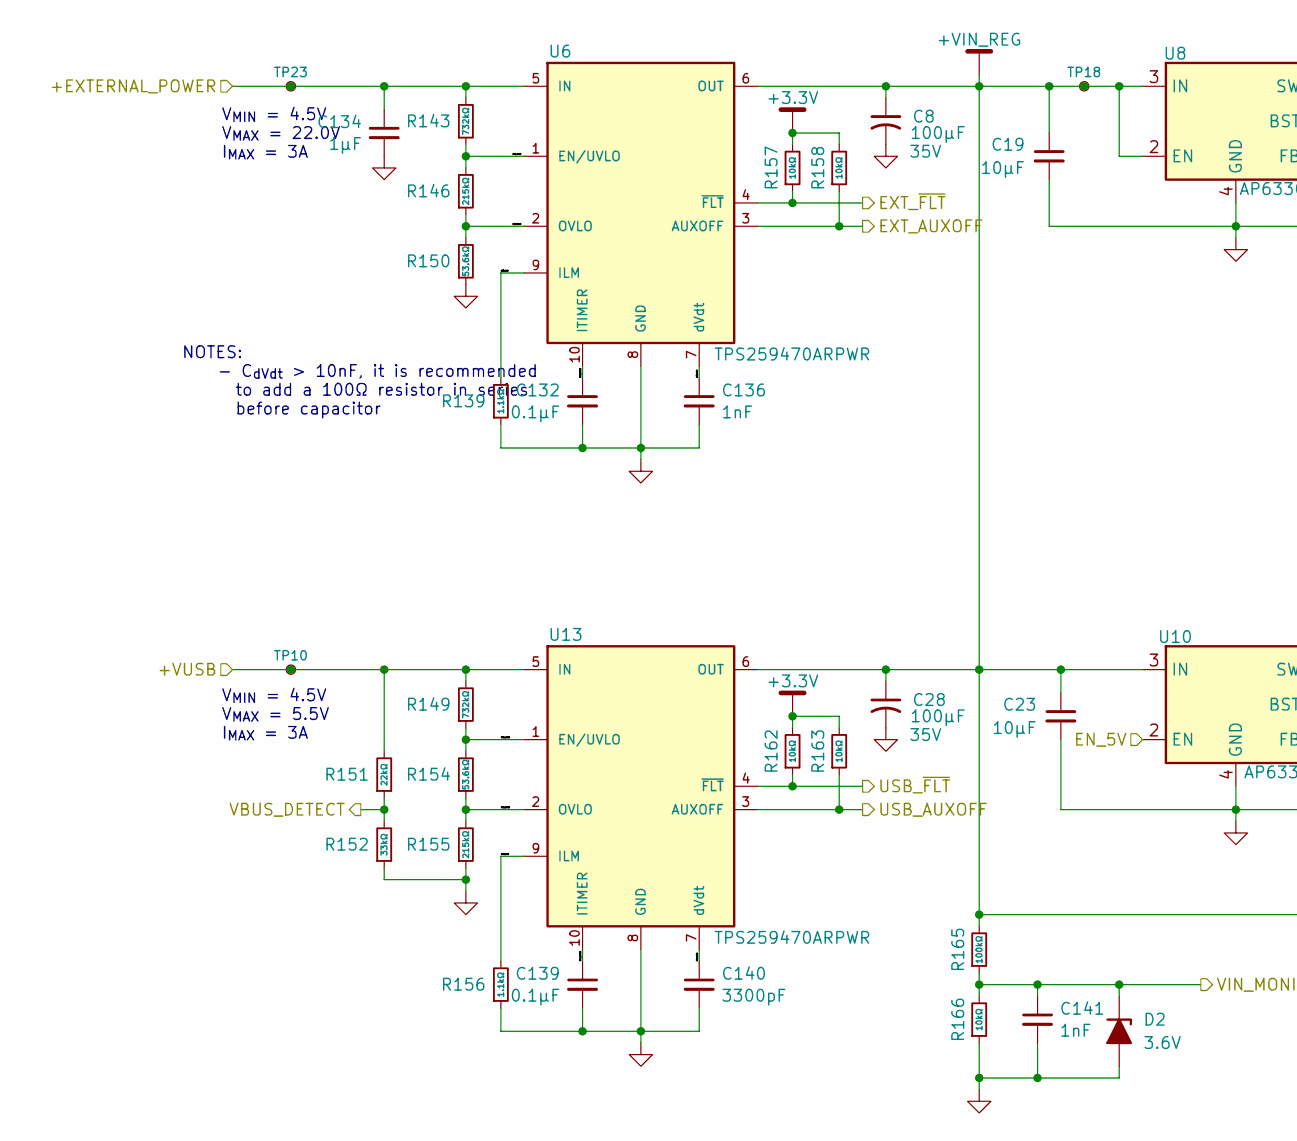
[picture p22: schematic phyduino2_power_regs.kicad_sch, Phyduino Pico 2, part in row 1, column 1]

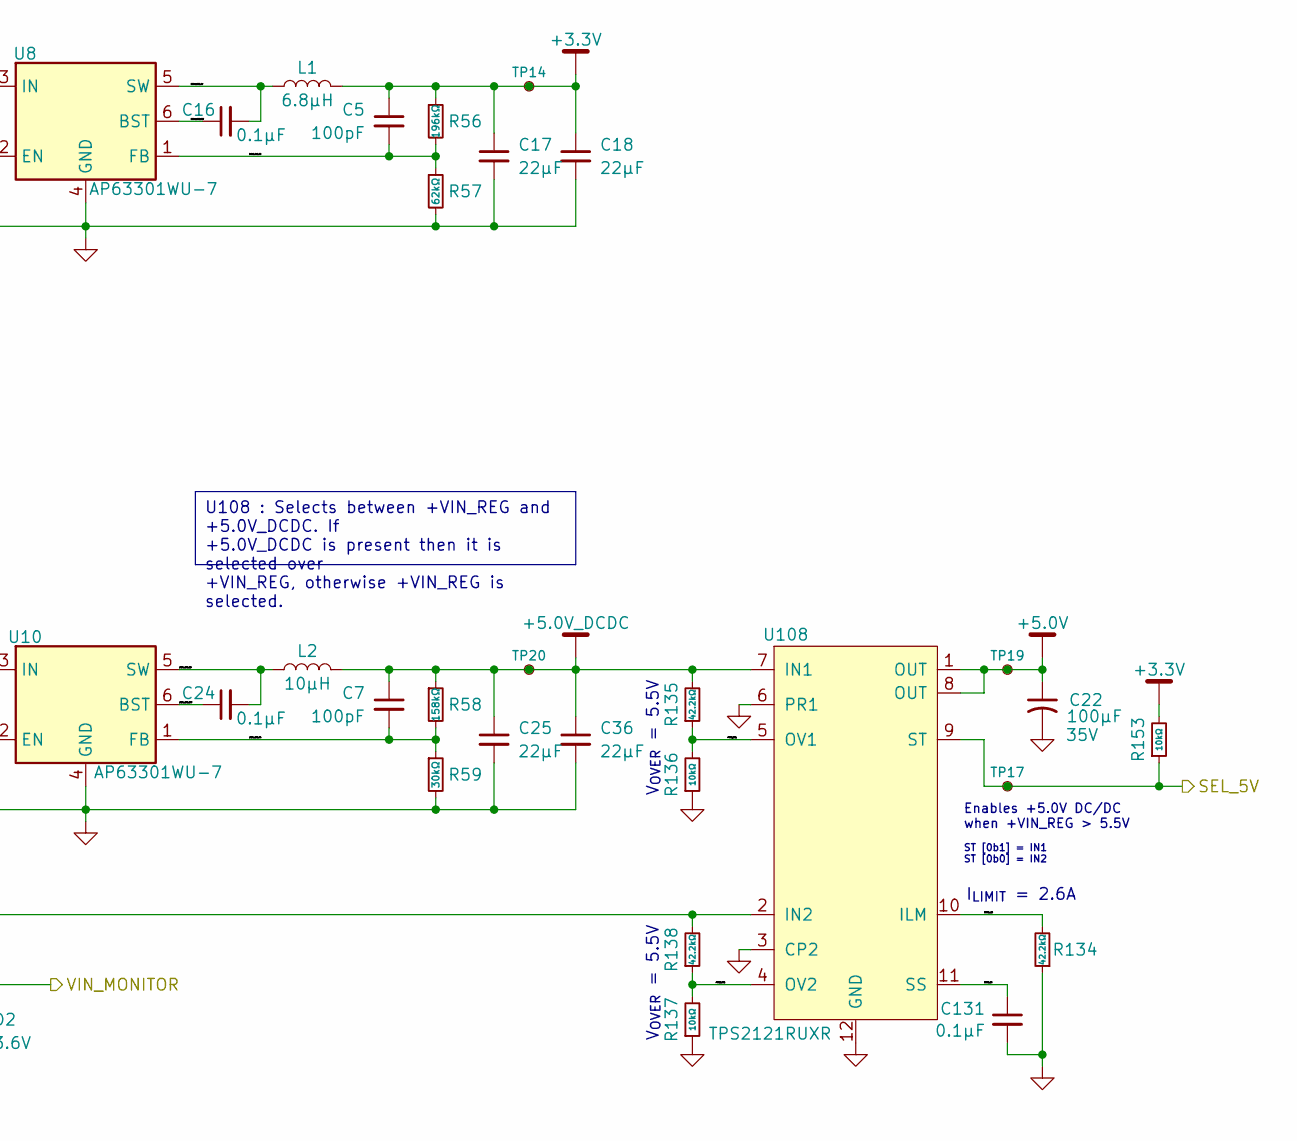
[picture p23: schematic phyduino2_power_regs.kicad_sch, Phyduino Pico 2, part in row 1, column 2]

Parts:
C5, C7: 100pF; C_0402_1005Metric; MOUSER_PN 187-CL05C101JB5NNNC; DIGIKEY_PN 1276-1025-1-ND
C8, C22, C28: 100µF; C_Elec_5x5.4; VOLTAGE 35V; DIGIKEY_PN 5011-VPXB0771E101MVTM-ND
C16, C24: 0.1µF; C_0805_2012Metric_Pad1.18x1.45mm_HandSolder; MOUSER_PN 187-CL21B104KBCNNNC; LCSC_PN C1711
C17, C18, C36: 22µF; C_1206_3216Metric_Pad1.33x1.80mm_HandSolder; Tolerance ±20%; MOUSER_PN 810-C3216X5R1E226M; DIGIKEY_PN 445-6000-1-ND
C19, C23: 10µF; C_0805_2012Metric_Pad1.18x1.45mm_HandSolder; MOUSER_PN 603-CC0805KKX59BB106; LCSC_PN C440198
C25: 22µF; C_1206_3216Metric_Pad1.33x1.80mm_HandSolder; Tolerance ±20%; VOLTAGE 25V; MOUSER_PN 810-C3216X5R1E226M; DIGIKEY_PN 445-6000-1-ND
C131, C132, C139: 0.1µF; C_0402_1005Metric; Tolerance ±10%; MOUSER_PN 81-GCM155R71H104KE2J; LCSC_PN C85858
C134: 1µF; C_0805_2012Metric_Pad1.18x1.45mm_HandSolder; Tolerance ±10%; MOUSER_PN 81-GCM21BR71H105KA3L; LCSC_PN C342759
C136, C141: 1nF; C_0402_1005Metric; MOUSER_PN 81-GRM1555C1H102JA1D; LCSC_PN C76947
C140: 3300pF; C_0402_1005Metric; MOUSER_PN 81-GRM36X332K50; LCSC_PN C85963
D2: 3.6V; D_SOD-323; MOUSER_PN 863-MM3Z3V6T1G; DIGIKEY_PN MM3Z3V6T1GOSCT-ND
L1: 6.8µH; L_Bourns_SRP4021HMCT; MOUSER_PN 652-SRP4021HMCT-6R8M; LCSC PN C47146736
L2: 10µH; L_Bourns_SRP4021HMCT; MOUSER_PN 652-SRP4021HMCT-100M; LCSC PN C47146732
R56: 196kΩ; R_0402_1005Metric; MOUSER_PN 603-RC0402FR-07196KL; LCSC_PN C26996
R57: 62kΩ; R_0402_1005Metric; MOUSER_PN 603-RC0402FR-0762KL; LCSC_PN C2909375
R58: 158kΩ; R_0402_1005Metric; MOUSER_PN 603-RC0402FR-07158KL; LCSC_PN C4014665
R59: 30kΩ; R_0402_1005Metric; MOUSER_PN 603-RC0402FR-0730KL; LCSC_PN C138008
R134, R135, R138: 42.2kΩ; R_0402_1005Metric; MOUSER_PN 603-RC0402FR-0742K2L; LCSC_PN C276270
R136, R137, R153, R157, R158, R162, R163, R166: 10kΩ; R_0402_1005Metric; MOUSER_PN 603-RC0402FR-0710KL; LCSC_PN C60490
R139, R156: 1.1kΩ; R_0402_1005Metric; MOUSER_PN 603-RC0402FR-071K1L; LCSC_PN C2909306
R143, R149: 732kΩ; R_0402_1005Metric; MOUSER_PN 603-RC0402FR-07732KL; LCSC_PN C5159692
R146, R155: 215kΩ; R_0402_1005Metric; MOUSER_PN 603-RC0402FR-07215KL; LCSC_PN C11489
R150, R154: 53.6kΩ; R_0402_1005Metric; MOUSER_PN 603-RC0402FR-0753K6L; LCSC_PN C5153961
R151: 22kΩ; R_0402_1005Metric; MOUSER_PN 603-RC0402FR-0722KL; LCSC_PN C413100
R152: 33kΩ; R_0402_1005Metric; MOUSER_PN 603-RC0402FR-0733KL; LCSC_PN C25779
R165: 100kΩ; R_0402_1005Metric; MOUSER_PN 603-RC0402FR-07100KL; LCSC_PN C60491
TP10, TP14, TP17, TP18, TP19, TP20, TP23: TestPoint_Small; TestPoint_SameSky_CPG-47-TH-B
U6, U13: TPS259470ARPWR; Texas_Instruments_VQFN-HR-10; MOUSER_PN 595-TPS259470ARPWR; DIGIKEY_PN 296-TPS259470ARPWRCT-ND
U8, U10: AP63301WU-7; TSOT-23-6_HandSoldering; MOUSER_PN 621-AP63301WU-7; DIGIKEY_PN 31-AP63301WU-7CT-ND
U108: TPS2121RUXR; VQFN-HR-12; MOUSER_PN 595-TPS2121RUXR; LCSC_PN C485916

Connections:
+3.3V: C5.1, C17.1, C18.1, L1.2, R56.1, R153.2, R157.2, R158.2, R162.2, R163.2, TP14.1 (1_1); also elsewhere on the board
+5.0V: C22.1, TP19.1 (1_1), U108.1 (OUT), U108.8 (OUT); also elsewhere on the board
+5.0V_DCDC: C7.1, C25.1, C36.1, L2.2, R58.1, R135.2, TP20.1 (1_1), U108.7 (IN1)
+VIN_REG: C8.1, C19.1, C23.1, C28.1, R138.2, R165.2, TP18.1 (1_1), U6.6 (OUT), U8.2 (EN), U8.3 (IN), U10.3 (IN), U13.6 (OUT), U108.2 (IN2)
+V_{EXTERNAL}: C134.1, R143.2, TP23.1 (1_1), U6.5 (IN); also elsewhere on the board
+V_{USB}: R149.2, R151.2, TP10.1 (1_1), U13.5 (IN); also elsewhere on the board
/Microcontroller/EN_5V: U10.2 (EN); also elsewhere on the board
/Microcontroller/EXT_AUXOFF: R158.1, U6.3 (AUXOFF); also elsewhere on the board
/Microcontroller/EXT_~FLT: R157.1, U6.4 (~FLT); also elsewhere on the board
/Microcontroller/PSW_STATUS: R153.1, TP17.1 (1_1), U108.9 (ST); also elsewhere on the board
/Microcontroller/USB_AUXOFF: R163.1, U13.3 (AUXOFF); also elsewhere on the board
/Microcontroller/USB_~FLT: R162.1, U13.4 (~FLT); also elsewhere on the board
/Microcontroller/VBUS_DETECT: R151.1, R152.2; also elsewhere on the board
/Microcontroller/VIN_MONITOR: C141.1, D2.1 (K), R165.1, R166.2; also elsewhere on the board
/Power/DCDC_3V3_BST: C16.1, U8.6 (BST)
/Power/DCDC_3V3_FB: C5.2, R56.2, R57.1, U8.1 (FB)
/Power/DCDC_3V3_SW: C16.2, L1.1, U8.5 (SW)
/Power/DCDC_5V0_BST: C24.1, U10.6 (BST)
/Power/DCDC_5V0_FB: C7.2, R58.2, R59.1, U10.1 (FB)
/Power/DCDC_5V0_SW: C24.2, L2.1, U10.5 (SW)
/Power/EXT_ILIM: R139.2, U6.9 (ILM)
/Power/EXT_ITIMER: C132.1, U6.10 (ITIMER)
/Power/EXT_OVLO: R146.1, R150.2, U6.2 (OVLO)
/Power/EXT_UVLO: R143.1, R146.2, U6.1 (EN/UVLO)
/Power/EXT_dVdt: C136.1, U6.7 (dVdt)
/Power/PMUX_LIM: R134.2, U108.10 (ILM)
/Power/PMUX_OV1: R135.1, R136.2, U108.5 (OV1)
/Power/PMUX_OV2: R137.2, R138.1, U108.4 (OV2)
/Power/PMUX_SS: C131.1, U108.11 (SS)
/Power/USB_ILIM: R156.2, U13.9 (ILM)
/Power/USB_ITIMER: C139.1, U13.10 (ITIMER)
/Power/USB_OVLO: R154.1, R155.2, U13.2 (OVLO)
/Power/USB_UVLO: R149.1, R154.2, U13.1 (EN/UVLO)
/Power/USB_dVdt: C140.1, U13.7 (dVdt)
GND: C8.2, C17.2, C18.2, C19.2, C22.2, C23.2, C25.2, C28.2, C36.2, C131.2, C132.2, C134.2, C136.2, C139.2, C140.2, C141.2, D2.2 (A), R57.2, R59.2, R134.1, R136.1, R137.1, R139.1, R150.1, R152.1, R155.1, R156.1, R166.1, U6.8 (GND), U8.4 (GND), U10.4 (GND), U13.8 (GND), U108.3 (CP2), U108.6 (PR1), U108.12 (GND); also elsewhere on the board

Notes on the sheet:
V_{MIN} = 4.5V V_{MAX} = 5.5V I_{MAX} = 3A
NOTES: - C_{dVdt} > 10nF, it is recommended to add a 100Ω resistor in series before capacitor
Enables +5.0V DC/DC when +VIN_REG > 5.5V
V_{OVER} = 5.5V
V_{MIN} = 4.5V V_{MAX} = 22.0V I_{MAX} = 3A
I_{LIMIT} = 2.6A
ST [0b1] = IN1 ST [0b0] = IN2
U108 : Selects between +VIN_REG and +5.0V_DCDC. If +5.0V_DCDC is present then it is selected over +VIN_REG, otherwise +VIN_REG is selected.

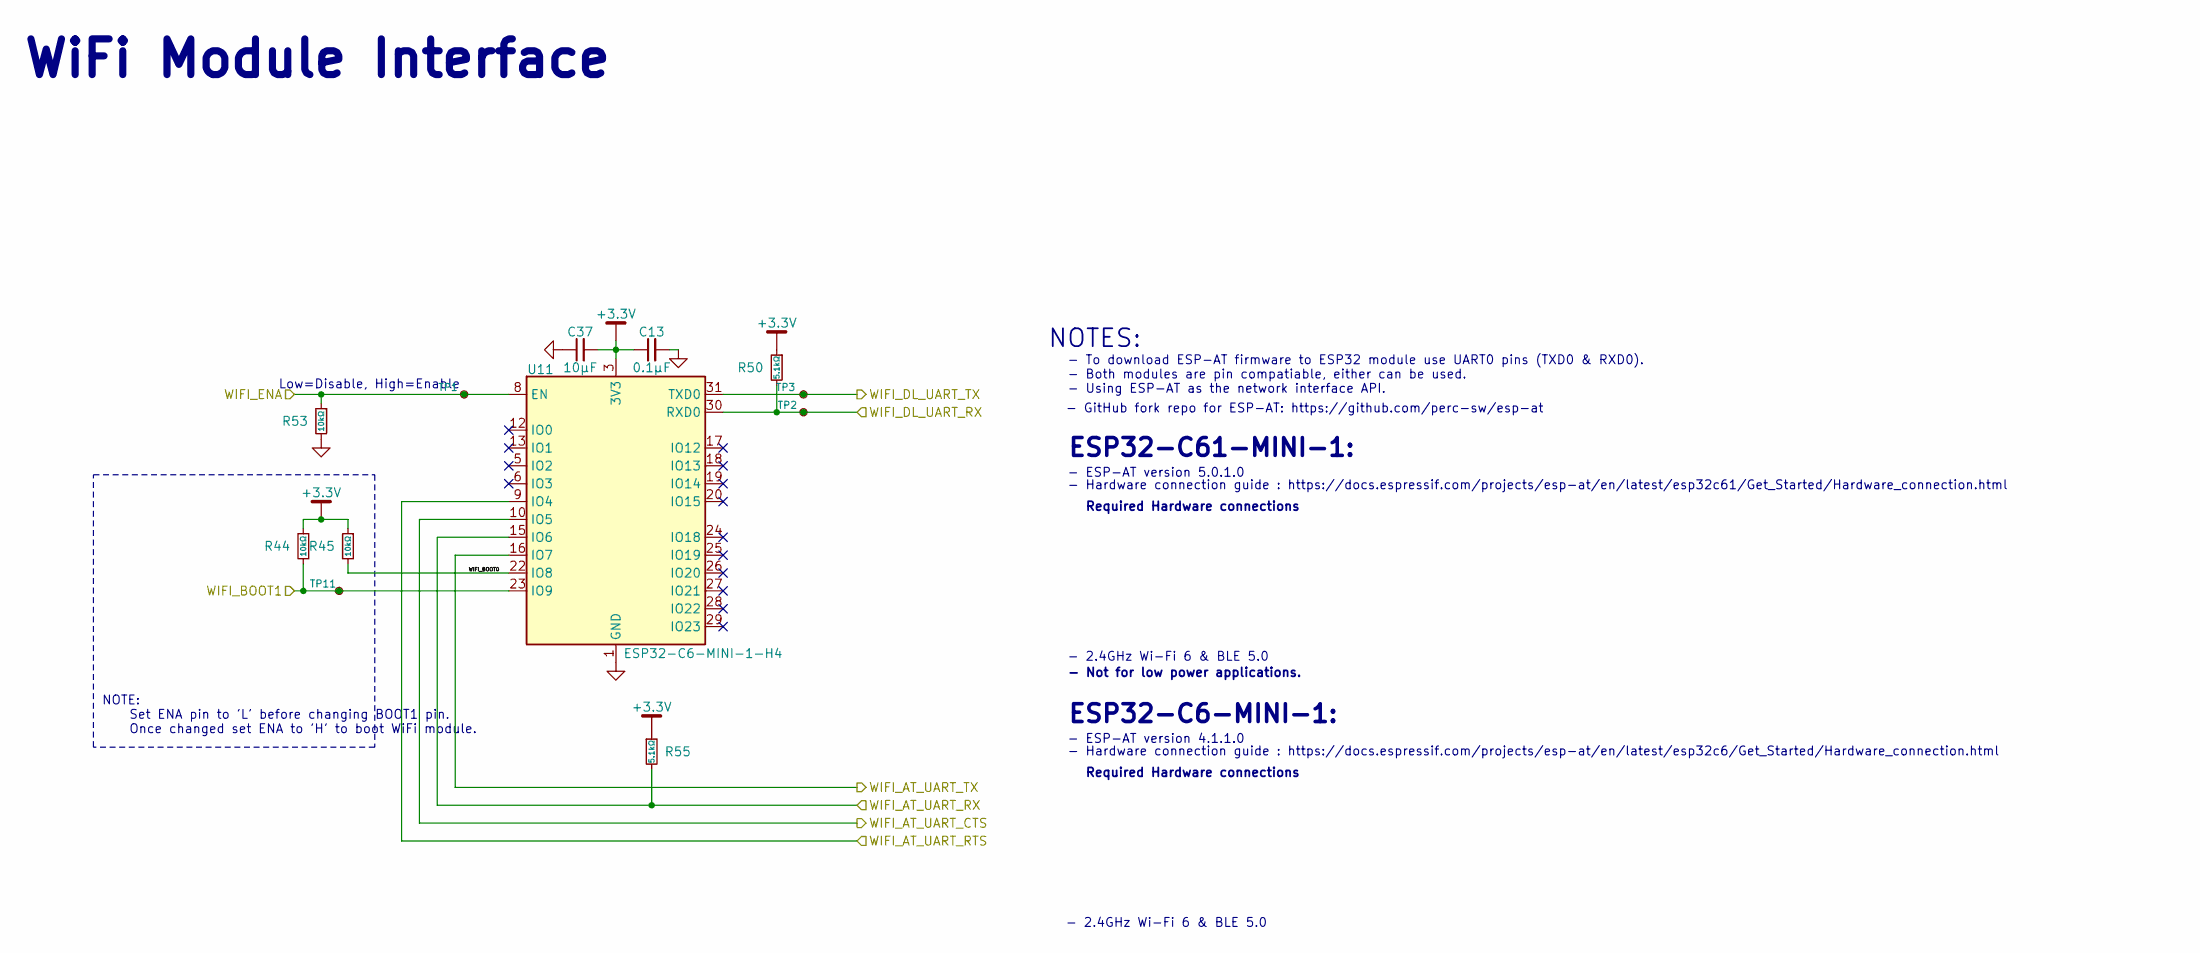
[picture p24: schematic phyduino_pico2_wifi.kicad_sch, Phyduino Pico 2]

Parts:
C13: 0.1µF; C_0402_1005Metric; Tolerance ±10%; MOUSER_PN 81-GCM155R71H104KE2J; LCSC_PN C85858
C37: 10µF; C_0805_2012Metric_Pad1.18x1.45mm_HandSolder; Tolerance ±10%; MOUSER_PN 603-CC0805KKX59BB106; LCSC_PN C440198
R44, R45, R53: 10kΩ; R_0402_1005Metric; MOUSER_PN 603-RC0402FR-0710KL; LCSC_PN C60490
R50, R55: 5.1kΩ; R_0402_1005Metric; MOUSER_PN 603-RC0402FR-075K1L; LCSC_PN C105872
TP1, TP2, TP3, TP11: TestPoint_Small; TestPoint_SameSky_CPG-47-TH-B
U11: ESP32-C6-MINI-1-H4; ESP32-C6-MINI-1; MOUSER_PN 356-ESP32C6MINI1-H4; DIGIKEY_PN 1965-ESP32-C6-MINI-1-H4CT-ND

Connections:
+3.3V: C13.1, C37.2, R44.1, R45.1, R50.1, R55.1, U11.3 (3V3); also elsewhere on the board
/Microcontroller/WIFI_BOOT1: R44.2, TP11.1 (1_1), U11.23 (IO9); also elsewhere on the board
/Microcontroller/WIFI_DL_UART_RX: TP3.1 (1_1), U11.31 (TXD0); also elsewhere on the board
/Microcontroller/WIFI_DL_UART_TX: R50.2, TP2.1 (1_1), U11.30 (RXD0); also elsewhere on the board
/Microcontroller/WIFI_ENA: R53.1, TP1.1 (1_1), U11.8 (EN); also elsewhere on the board
/Microcontroller/WIFI_UART_CTS: U11.9 (IO4); also elsewhere on the board
/Microcontroller/WIFI_UART_RTS: U11.10 (IO5); also elsewhere on the board
/Microcontroller/WIFI_UART_RX: U11.16 (IO7); also elsewhere on the board
/Microcontroller/WIFI_UART_TX: R55.2, U11.15 (IO6); also elsewhere on the board
/Wireless Communication/WIFI_BOOT0: R45.2, U11.22 (IO8)
GND: C13.2, C37.1, R53.2, U11.1 (GND), U11.2 (GND), U11.11 (GND), U11.14 (GND), U11.36 (GND), U11.37 (GND), U11.38 (GND), U11.39 (GND), U11.40 (GND), U11.41 (GND), U11.42 (GND), U11.43 (GND), U11.44 (GND), U11.45 (GND), U11.46 (GND), U11.47 (GND), U11.48 (GND), U11.49 (GND), U11.50 (GND), U11.51 (GND), U11.52 (GND), U11.53 (GND); also elsewhere on the board

Notes on the sheet:
- ESP-AT version 5.0.1.0
Required Hardware connections
- Both modules are pin compatiable, either can be used.
- Hardware connection guide : https://docs.espressif.com/projects/esp-at/en/latest/esp32c6/Get_Started/Hardware_connection.html
NOTES:
ESP32-C61-MINI-1:
- To download ESP-AT firmware to ESP32 module use UART0 pins (TXD0 & RXD0).
WiFi Module Interface
- Using ESP-AT as the network interface API.
ESP32-C6-MINI-1:
- Not for low power applications.
NOTE: Set ENA pin to 'L' before changing BOOT1 pin. Once changed set ENA to 'H' to boot WiFi module.
- GitHub fork repo for ESP-AT: https://github.com/perc-sw/esp-at
- 2.4GHz Wi-Fi 6 & BLE 5.0
- ESP-AT version 4.1.1.0
Low=Disable, High=Enable
- Hardware connection guide : https://docs.espressif.com/projects/esp-at/en/latest/esp32c61/Get_Started/Hardware_connection.html
