perc-sw/phyduino_pico2/phyduino_pico2.kicad_pcb

## KiCad design phyduino_pico2.kicad_pcb (continued)

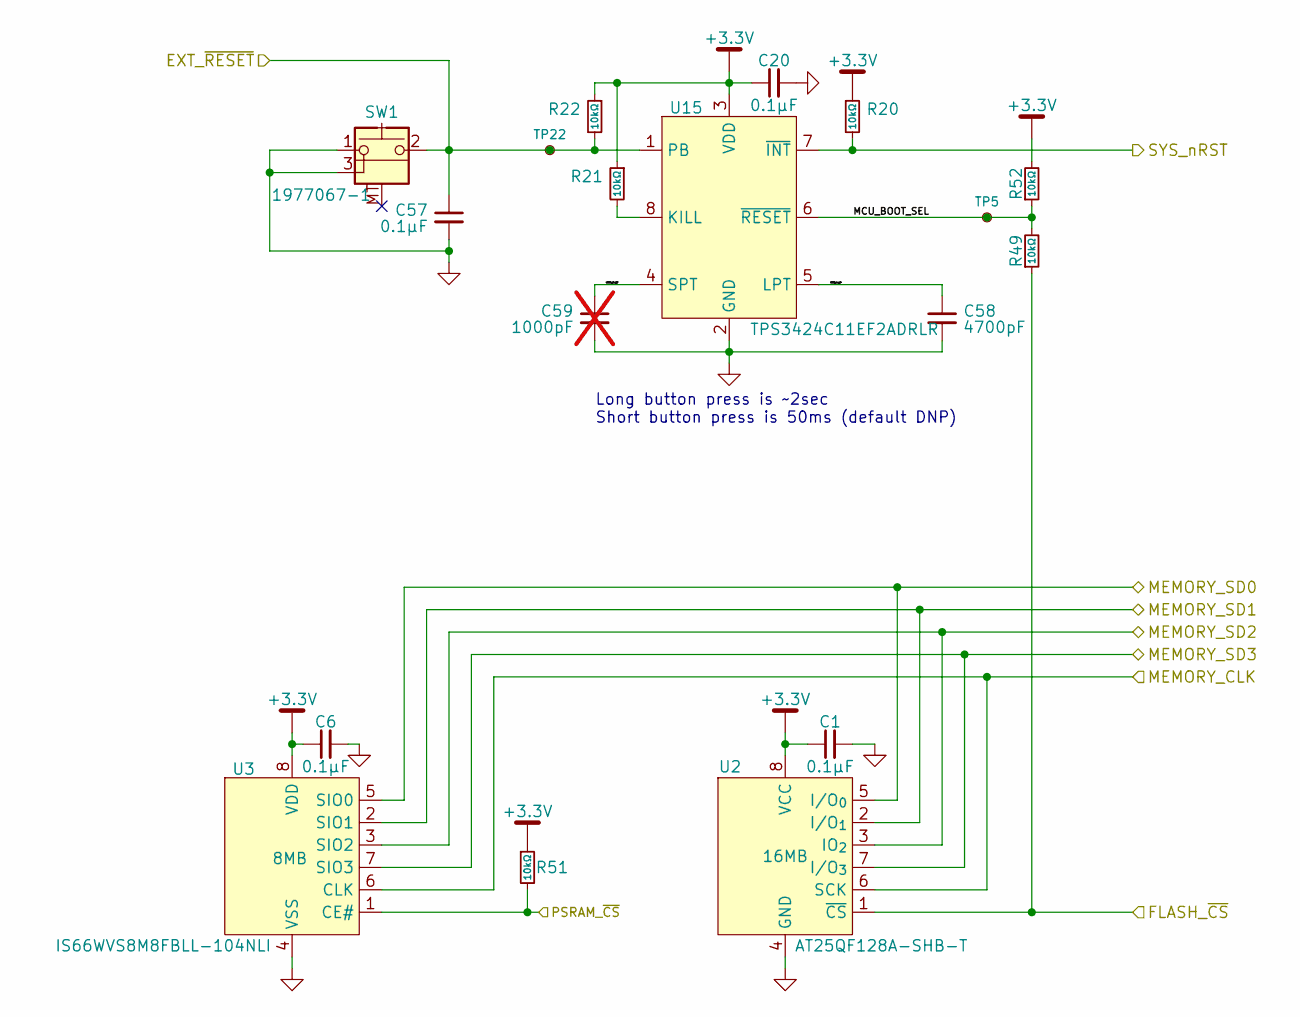
[picture p25: schematic phyduino_pico_memory.kicad_sch, Phyduino Pico 2]

Parts:
C1, C6, C20, C57: 0.1µF; C_0402_1005Metric; Tolerance ±10%; MOUSER_PN 81-GCM155R71H104KE2J; LCSC_PN C85858
C58: 4700pF; C_0402_1005Metric; Tolerance ±5%; MOUSER_PN 81-GRM1555C1H472JE1D; LCSC_PN C1518204
C59: 1000pF; C_0402_1005Metric; Tolerance ±5%; MOUSER_PN 81-GRM1555C1H102JA1D; LCSC_PN C76947; not fitted
R20, R21, R22, R49, R51, R52: 10kΩ; R_0402_1005Metric; MOUSER_PN 603-RC0402FR-0710KL; LCSC_PN C60490
SW1: 1977067-1; TE_1977067-1; LCSC PN C2972216
TP5, TP22: TestPoint_Small; TestPoint_SameSky_CPG-47-TH-B
U2: AT25QF128A-SHB-T; SOIC-8_5.3x5.3mm_P1.27mm; MOUSER_PN 988-AT25QF128A-SHB-T; DIGIKEY_PN 1695-AT25QF128A-SHB-TCT-ND
U3: IS66WVS8M8FBLL-104NLI; SOIC-8_3.9x4.9mm_P1.27mm; MOUSER_PN 870-WVS8M8FBLL104NLI; DIGIKEY_PN 706-IS66WVS8M8FBLL-104NLI-ND
U15: TPS3424C11EF2ADRLR; SOT-5x3_DRL0008A_TEX; MOUSER_PN 595-S3424C11EF2ADRLR; DIGIKEY_PN 296-TPS3424C11EF2ADRLRCT-ND

Connections:
+3.3V: C1.1, C6.1, C20.1, R20.1, R21.1, R22.1, R51.1, R52.2, U2.8 (VCC), U3.8 (VDD), U15.3 (VDD); also elsewhere on the board
/Microcontroller/EXT_~RESET: C57.1, R22.2, SW1.2, TP22.1 (1_1), U15.1 (PB); also elsewhere on the board
/Microcontroller/FLASH_CLK: U2.6 (SCK), U3.6 (CLK); also elsewhere on the board
/Microcontroller/FLASH_SD0: U2.5 (I/O_{0}), U3.5 (SIO0); also elsewhere on the board
/Microcontroller/FLASH_SD1: U2.2 (I/O_{1}), U3.2 (SIO1); also elsewhere on the board
/Microcontroller/FLASH_SD2: U2.3 (IO_{2}), U3.3 (SIO2); also elsewhere on the board
/Microcontroller/FLASH_SD3: U2.7 (I/O_{3}), U3.7 (SIO3); also elsewhere on the board
/Microcontroller/FLASH_~CS: R49.1, U2.1 (~CS); also elsewhere on the board
/Microcontroller/Memory/BOOT_LP_CAP: C58.1, U15.5 (LPT)
/Microcontroller/Memory/MCU_BOOT_SEL: R49.2, R52.1, TP5.1 (1_1), U15.6 (~RESET)
/Microcontroller/Memory/RESET_SP_CAP: C59.1, U15.4 (SPT)
/Microcontroller/SYS_nRST: R20.2, U15.7 (~INT); also elsewhere on the board
GND: C1.2, C6.2, C20.2, C57.2, C58.2, C59.2, SW1.1, SW1.3 (1), U2.4 (GND), U3.4 (VSS), U15.2 (GND); also elsewhere on the board
unnamed: R21.2, U15.8 (KILL)
PSRAM_CE#: R51.2, U3.1 (CE#); also elsewhere on the board

Notes on the sheet:
Long button press is ~2sec Short button press is 50ms (default DNP)

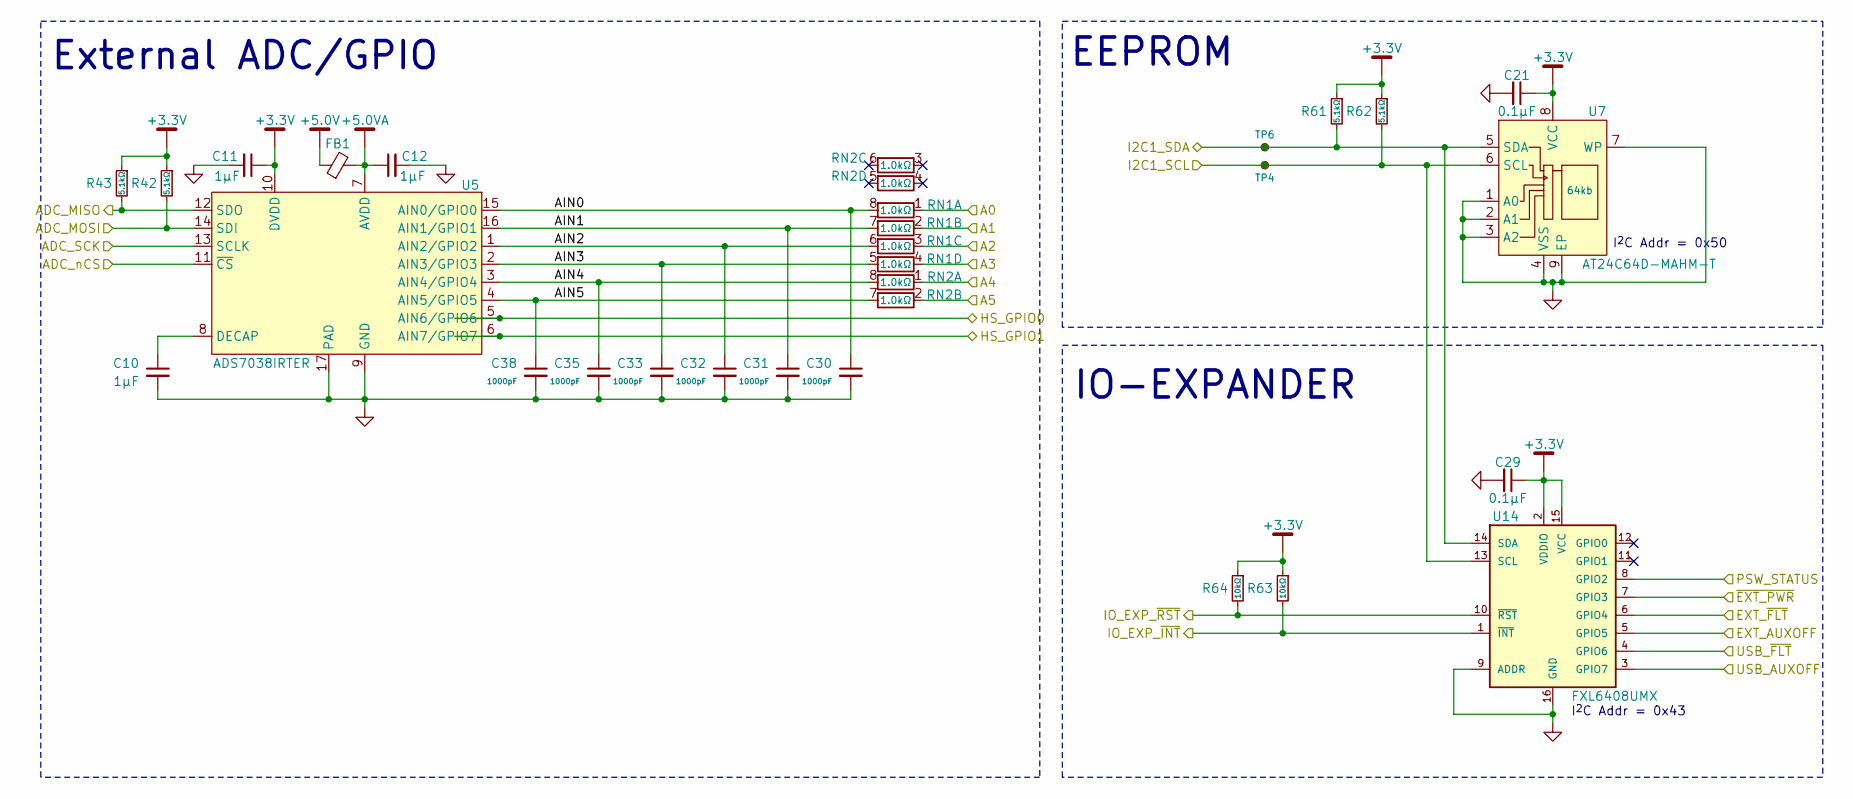
[picture p26: schematic phyduino_pico_peripherals.kicad_sch, Phyduino Pico 2]

Parts:
C10, C11, C12: 1µF; C_0805_2012Metric_Pad1.18x1.45mm_HandSolder; Tolerance ±10%; MOUSER_PN 81-GCM21BR71H105KA3L; LCSC_PN C342759
C21, C29: 0.1µF; C_0402_1005Metric; Tolerance ±10%; MOUSER_PN 81-GCM155R71H104KE2J; LCSC_PN C85858
C30, C31, C32, C33, C35, C38: 1000pF; C_0402_1005Metric; Tolerance ±5%; MOUSER_PN 81-GRM1555C1H102JA1D; LCSC_PN C76947
FB1: 1kΩ@100MHz; L_0805_2012Metric_Pad1.05x1.20mm_HandSolder; MOUSER_PN 875-HZ0805D102R-10; LCSC_PN C85835
R42, R43, R61, R62: 5.1kΩ; R_0402_1005Metric; MOUSER_PN 603-RC0402FR-075K1L; LCSC_PN C105872
R63, R64: 10kΩ; R_0402_1005Metric; MOUSER_PN 603-RC0402FR-0710KL; LCSC_PN C60490
RN1, RN2: 1.0kΩ; RESCAV50P200X100X55-8N; MOUSER_PN 652-CAT10-102J4LF; DIGIKEY_PN CAT10-102J4LFCT-ND
TP4, TP6: TestPoint_Small; TestPoint_SameSky_CPG-47-TH-B
U5: ADS7038IRTER; QFN50P300X300X80-17N; MOUSER_PN 595-ADS7038IRTER; LCSC_PN C2871580
U7: AT24C64D-MAHM-T; DFN-8-1EP_3x2mm_P0.5mm_EP1.3x1.4mm; LCSC_PN C2061553
U14: FXL6408UMX; QFN40P260X180X55-16N; MOUSER_PN 512-FXL6408UMX; DIGIKEY_PN FXL6408UMXCT-ND

Connections:
+3.3V: C11.1, C21.1, C29.1, R42.1, R43.1, R61.1, R62.1, R63.1, R64.1, U5.10 (DVDD), U7.8 (VCC), U14.2 (VDDIO), U14.15 (VCC); also elsewhere on the board
+5.0V: FB1.1; also elsewhere on the board
+5.0VA: C12.1, FB1.2, U5.7 (AVDD)
/Microcontroller/A0: RN1.1 (R1.1); also elsewhere on the board
/Microcontroller/A1: RN1.2 (R2.1); also elsewhere on the board
/Microcontroller/A2: RN1.3 (R3.1); also elsewhere on the board
/Microcontroller/A3: RN1.4 (R4.1); also elsewhere on the board
/Microcontroller/A4: RN2.1 (R1.1); also elsewhere on the board
/Microcontroller/A5: RN2.2 (R2.1); also elsewhere on the board
/Microcontroller/ADC_MISO: R43.2, U5.12 (SDO); also elsewhere on the board
/Microcontroller/ADC_MOSI: R42.2, U5.14 (SDI); also elsewhere on the board
/Microcontroller/ADC_SCK: U5.13 (SCLK); also elsewhere on the board
/Microcontroller/ADC_nCS: U5.11 (~CS); also elsewhere on the board
/Microcontroller/EXT_AUXOFF: U14.5 (GPIO5); also elsewhere on the board
/Microcontroller/EXT_~FLT: U14.6 (GPIO4); also elsewhere on the board
/Microcontroller/HS_GPIO0: U5.5 (AIN6/GPIO6); also elsewhere on the board
/Microcontroller/HS_GPIO1: U5.6 (AIN7/GPIO7); also elsewhere on the board
/Microcontroller/I2C1_SCL: R62.2, TP4.1 (1_1), U7.6 (SCL), U14.13 (SCL); also elsewhere on the board
/Microcontroller/I2C1_SDA: R61.2, TP6.1 (1_1), U7.5 (SDA), U14.14 (SDA); also elsewhere on the board
/Microcontroller/IO_EXP_~INT: R63.2, U14.1 (~INT); also elsewhere on the board
/Microcontroller/IO_EXP_~RST: R64.2, U14.10 (~RST); also elsewhere on the board
/Microcontroller/PSW_STATUS: U14.8 (GPIO2); also elsewhere on the board
/Microcontroller/Peripherals/AIN0: C30.1, RN1.8 (R1.2), U5.15 (AIN0/GPIO0)
/Microcontroller/Peripherals/AIN1: C31.1, RN1.7 (R2.2), U5.16 (AIN1/GPIO1)
/Microcontroller/Peripherals/AIN2: C32.1, RN1.6 (R3.2), U5.1 (AIN2/GPIO2)
/Microcontroller/Peripherals/AIN3: C33.1, RN1.5 (R4.2), U5.2 (AIN3/GPIO3)
/Microcontroller/Peripherals/AIN4: C35.1, RN2.8 (R1.2), U5.3 (AIN4/GPIO4)
/Microcontroller/Peripherals/AIN5: C38.1, RN2.7 (R2.2), U5.4 (AIN5/GPIO5)
/Microcontroller/USB_AUXOFF: U14.3 (GPIO7); also elsewhere on the board
/Microcontroller/USB_~FLT: U14.4 (GPIO6); also elsewhere on the board
/Microcontroller/~EXT_PWR: U14.7 (GPIO3); also elsewhere on the board
GND: C10.2, C11.2, C12.2, C21.2, C29.2, C30.2, C31.2, C32.2, C33.2, C35.2, C38.2, U5.9 (GND), U5.17 (PAD), U7.1 (A0), U7.2 (A1), U7.3 (A2), U7.4 (VSS), U7.7 (WP), U7.9 (EP), U14.9 (ADDR), U14.16 (GND); also elsewhere on the board
unnamed: C10.1, U5.8 (DECAP)

Notes on the sheet:
External ADC/GPIO
EEPROM
IO-EXPANDER
I^{2}C Addr = 0x50
I^{2}C Addr = 0x43

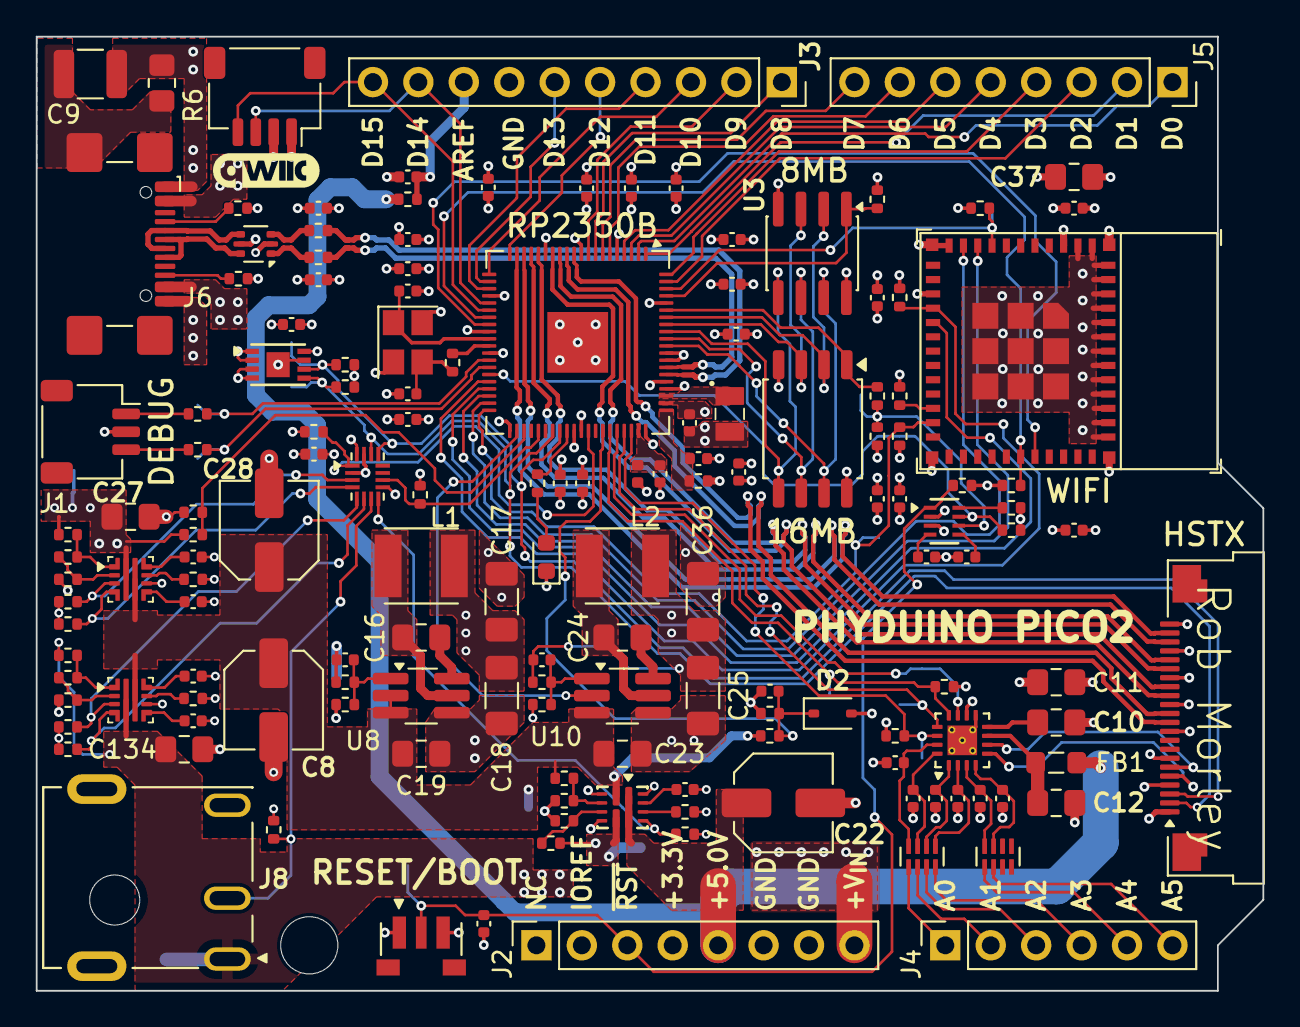
[picture p27: board phyduino_pico2.kicad_pcb from above]

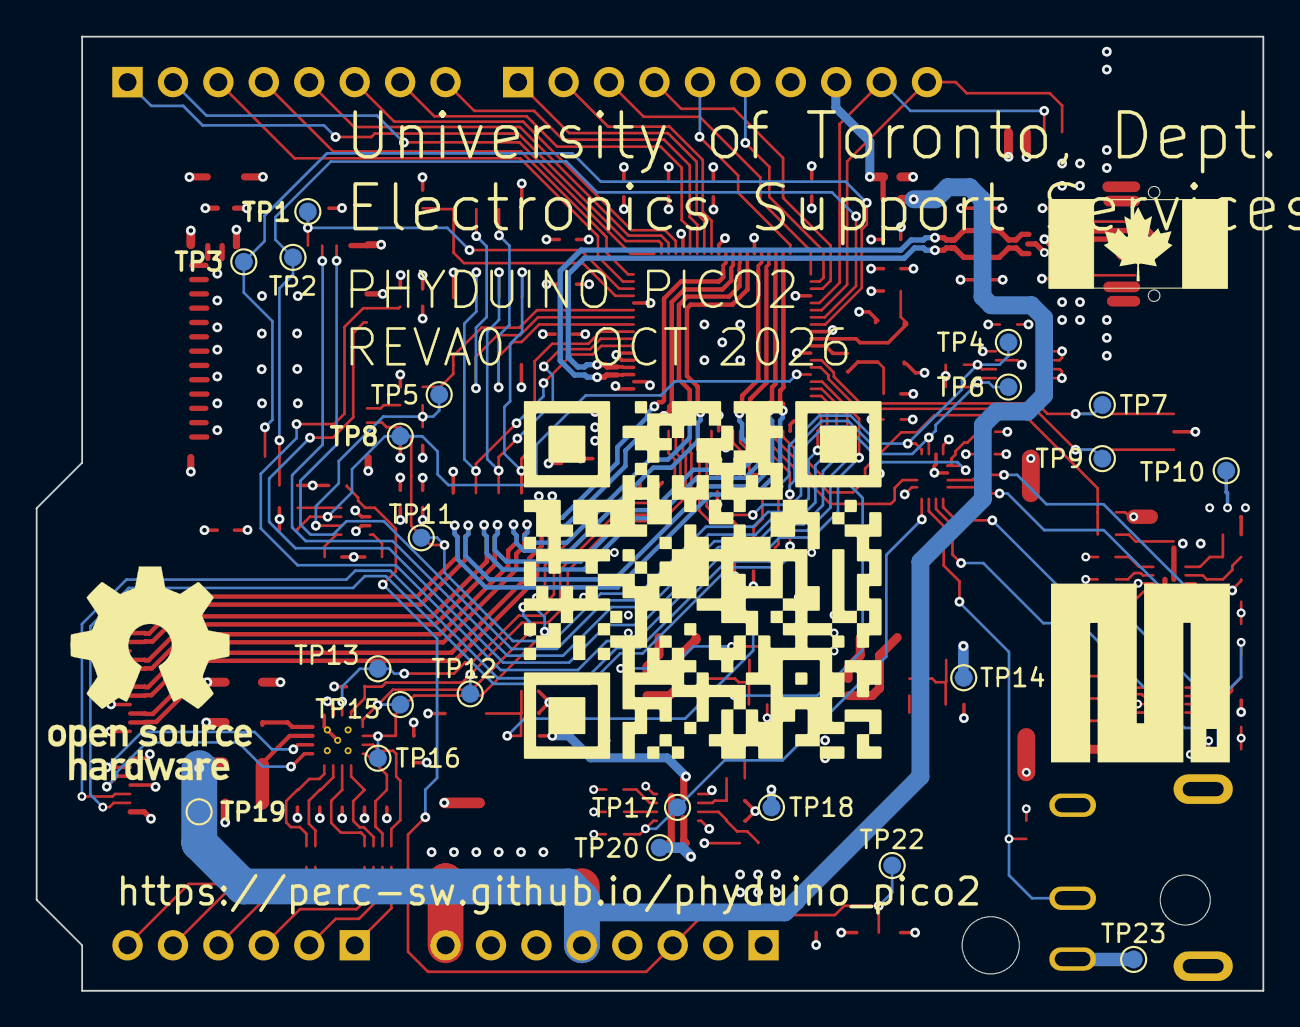
[picture p28: board phyduino_pico2.kicad_pcb from below]

Board: 4 copper layers, 68.6 x 53.3 mm, 175 parts (22 on the bottom side), 129 nets.
