perc-sw/phyduino_pico2/(commit log)

2026-05-05 Fixed USB routing issue at the COM port connector.
2026-05-11 Made schematic changes : merged usb_pd sheet with wifi sheet. made system regulators adjustable.
2026-05-11 Added datasheets for ESP32-C61 module and added wifi prefix to ESP-C6 datasheet
2026-05-13 output svg files of PCB.
2026-05-13 updated pdf files to match current PCB layout.
2026-05-13 updated PCB design.
2026-05-14 Add pwm label to legend.
2026-05-31 Updated board documentation.
2026-06-12 Made changes to the power tree to allow +Vin to power the board.
2026-06-12 Updated board rendering base on new layout.
2026-06-15 Changed power tree to accept +Vin.
2026-07-04 Updated PCB fonts
2026-07-10 Built board without USB-PD variant. Not yet complete.
2026-09-29 Development update : Changed the power input and tree, removed led for communication status.
2026-10-07 Development update : Initial design review changes and PCB routing.
2026-10-07 Docs update : Schematic review progress and current-design datasheets.
    - Review report: critical/high findings #1-#8 resolved; medium #10-#15,
    #24, #26 and low #16-#22, #25 closed; #9 open, #23 deferred. Added
    findings #24-#26 and follow-ups.
    - Datasheets: added AT25QF128A, IS66WVR8M8FBLL, ZD24C64A, FXL6408,
    TPS25947 and TPS3424; removed PCA9570, AT25SF128A, 24AA64F, AP33772S
    and ESP32-C61-MINI-1, which are no longer in the design.
    - index.html: datasheet table matches the fitted ICs.
2026-10-07 Development update : Schematic review changes (findings #6-#26).
    - Pin map reworked onto 5 V-tolerant GPIOs; I2C1 shared by EEPROM,
    expander and J7 on GPIO38/39; UART1 shared by D0/D1 and ESP32 flashing.
    - Power: U10 enable on GPIO33 (EN_5V) with VIN_MONITOR on GPIO43;
    VIN works like an Uno's (J2.8 on +V_EXTERNAL, U12 removed); C22 moved
    to +5.0V; C134 added on +V_EXTERNAL; C27 10 uF, C140 3.3 nF; notes
    corrected.
    - A0-A5 protected with 1 kOhm arrays and 1 nF; R53 pull-down on WIFI_ENA;
    32 kHz labels removed; Y1 ABM8G with 12 pF load caps; I2C address
    notes corrected; Variants set on all parts.
2026-10-09 Resized schematic sheet to A from B. Add micropython logo to back silkscreen. Regenerated gerber files
2026-10-09 Add README.md file and regenerated gerber files
2026-10-14 Updated part numbers and distributor part nummbers after BoM review.
