perc-sw/phyduino_pico2/(notices)

Notices in the files:
README.md:
Licence: GPL v3
